retsyx/amity-esp32/amity-octopus-consortium/04-hardware-and-cec-runtime.md

# HDMI adapters and the local CEC runtime

This document owns hardware scope and the original local runtime with explicit user amendments. [Addressing](03-domain-model-and-addressing.md), [discovery](05-discovery-and-topology.md), [CEC behavior](06-cec-roles-and-message-policy.md) and [AGENTS.md](../AGENTS.md) define the operating model.

## Hardware scope

An Amity device supports the adapter capacity advertised by its compiled hardware profile. The existing board has one front/back adapter on GPIO1/GPIO2. The development XIAO ESP32-S3 profile supports up to four optional adapters, using overridable pairs 1/2, 5/6, 7/8 and 9/44. Each adapter has two independent CEC wires. Stable internal slots 0–3 are displayed as HDMI adapter 1–4; absent slots never compress numbering.

The shared limits in `components/amity_system/include/amity/hardware_limits.hpp`, Kconfig, release hardware identity and schemas must agree. Do not infer capacity from discoveries. Unsupported GPIO mappings or allocation errors cannot authorize driving an unintended wire. Keep the existing passive error/admin behavior of the selected profile.

The wires use external pull-ups with internal GPIO pulls disabled. Preserve the existing timer architecture and wire protocol/timing. A profile's GPIO mapping is part of firmware compatibility identity. Four-adapter simultaneous electrical/timing behavior requires its own physical qualification; a passing one-adapter capture is not that evidence.

## One original local runtime per adapter

Each configured adapter uses the same original front playback/back TV behavior and CEC algorithms. The owner task handles input, received frames, allocation/discovery, setup and completions while transmissions remain outstanding. Preserve original logical-address candidates, poll/announcement budgets, back-first scan, lowest usable back-device PA or saved fallback and the selected front PA, subject to the explicit live-default amendment below.

The **29 October 2026 scan/cache amendment** limits enumeration to boot, explicit UI scans and actual communication cache misses. Lookup cooldowns are 120 seconds independently per adapter side; boot/UI scans bypass eligibility and refresh their side timestamps. Logical-address claiming remains electrical maintenance and does not itself request a device scan. Activity edits preserve caches and active discovery progress without disconnecting an Amity; a side-only lookup scan retains the other side's records. [Discovery](05-discovery-and-topology.md) owns the full rule.

The distribution layer does not allocate identities from a persistent electrical-domain or proxy-resource graph. It selects an owner and adapter; the owner applies the original local algorithm there. Settings and actual hardware availability are separate from a stored approval to use an activity.

The shared `amity_hub` task has a 12 KiB internal-RAM stack. Coordinator activity
handling and owner-local execution can nest on that task even when equipment is
local. The `0.1.85` Xtensa Standby path retained at least 6,304 bytes before final
wire and runtime overhead, so the former 6 KiB allocation overflowed. This resource
allowance is shared across adapters and adds 6 KiB of internal RAM once. It
changes no CEC decisions, task priority, queue capacity or timing. Validate
boot/heap availability and actual Start/Standby wire effects when changing that
budget; [recorded evidence](15-validation-and-release-gates.md#functional-test-framework).

Synchronous ownership dispatch borrows one `OwnedIntent`: the dispatcher uses
a mutable reference to stamp sequence, setup and key-token fields, while the
facade and transport sender take const references. Queued commands and retained
key state own copies before the caller's request can expire. With the same
Xtensa optimization flags, the known nested Standby call-chain subtotal falls
from 6,112 to 3,968 bytes after this change, excluding final owner-send, CEC and
runtime overhead in both measurements. This is compiler stack-usage evidence,
not a runtime high-water measurement, and does not reduce the 12 KiB allocation
or change CEC behavior, IPC admission, deadlines or task ownership.

## Transmission and queue ownership

CEC mechanically transmits supplied frames and attempt budgets through one FIFO per wire, with eight queued-plus-active messages total. Releases share those eight slots. Full admission drops the submitted frame and logs it; every member of a rejected atomic batch is logged. No reserved release slot, executor outgoing backlog or later retry of a dropped release exists.

State and completion trackers belong to the original executor. Each held key continues after its own successful attempt; failed key TX ends it. New commands submit immediately without waiting for another key's ACK or queue capacity. Bounded task IPC remains appropriate where needed for causal request/state handoff.

The **29 October 2026 activity-sequencing amendment** requires a Start/Standby sequence to await each original lookup/command completion before its next step on the same Amity. Other owners and the owner loop may advance in parallel. During activity setting, ignore key presses before registering them; a release for an unregistered press is a no-op. Preserve the existing physical-input gate, with no ignored-press lifecycle or replay; normal independent keys resume after it clears. The continuation retains an original-function program counter in bounded semantic IPC, not CEC frames or a second transmit queue. [Activity execution](07-activity-planning-and-execution.md#2-reuse-the-original-decisions) owns this explicit sequencing rule.

## CEC connectivity and per-device settings

There are no separate adapter-presence inputs or attachment generations. A configured adapter exposes its actual CEC wires. A valid pulled-up bus permits normal CEC communication; device replies and command ACKs determine the result of each exchange. An absent adapter produces no CEC responses. Do not add a cache, sensor or bus-availability permission before ordinary owner-local lookup and transmission, or add detection pulses or pull-downs to a live CEC line.

Each adapter has its own saved default physical address. The owner uses it in the original startup algorithm; it is not a verified route or a stored PA-evidence grant. The final 2 November 2026 amendment permits explicit default edits to apply without reboot: after atomic save, select that adapter's stored latest scanned address when present, otherwise the new default. An applicable scan that finds no address clears the stored observation; normal scans keep the selected address stable until the next explicit default edit. No separate startup-source flag is retained. Apply through the owner task, reannounce an actually changed identity, preserve caches and authenticated connections, and do not enumerate. Configured-slot, fresh owner boot/settings-revision, idle/drain, authority and deadline checks remain. CEC silence does not prevent editing a configured slot. See [UI settings](20-user-interface.md#per-device-hdmi-adapter-settings-amendment--20-october-2026).

## Qualification

Host tests establish addressing, queue, state and transcript behavior. Physical checks must establish each GPIO/wire mapping, external electrical behavior, original CEC timing and ACK behavior, sparse/removable adapter safety, simultaneous adapter load and behavior under Wi-Fi/BLE/HTTPS load. Preserve the distinction between CEC ACK and actual AV picture/audio.
