retsyx/amity-esp32/tests/matter_pi_requirements.txt

# Isolated Raspberry Pi controller test tools; CPython 3.13 / Linux aarch64.
# Exact wheels used in the hardware tests. Firmware does not depend on these packages.
# wheel: aenum-3.1.17-py3-none-any.whl
aenum==3.1.17 --hash=sha256:8b883a37a04e74cc838ac442bdd28c266eae5bbf13e1342c7ef123ed25230139
# wheel: asttokens-3.0.2-py3-none-any.whl
asttokens==3.0.2 --hash=sha256:9da13157f5b28becde0bd374fc677dcd3c290614264eff096f167c469cd9f933
# wheel: cffi-2.1.1-cp313-cp313-manylinux2014_aarch64.manylinux_2_17_aarch64.whl
cffi==2.1.1 --hash=sha256:f16c709686a78c727bbbf059f92b0bf41c6fc60deec706d2dc19f529175a6125
# wheel: coloredlogs-15.0.1-py2.py3-none-any.whl
coloredlogs==15.0.1 --hash=sha256:612ee75c546f53e92e70049c9dbfcc18c935a2b9a53b66085ce9ef6a6e5c0934
# wheel: construct-2.10.70-py3-none-any.whl
construct==2.10.70 --hash=sha256:c80be81ef595a1a821ec69dc16099550ed22197615f4320b57cc9ce2a672cb30
# wheel: cryptography-50.0.1-cp311-abi3-manylinux_2_28_aarch64.whl
cryptography==50.0.1 --hash=sha256:e74591e283fe6eb956416c929eb58262a719fe0311fd9054c62c3350ed8760d8
# wheel: dacite-1.9.2-py3-none-any.whl
dacite==1.9.2 --hash=sha256:053f7c3f5128ca2e9aceb66892b1a3c8936d02c686e707bee96e19deef4bc4a0
# wheel: decorator-5.3.1-py3-none-any.whl
decorator==5.3.1 --hash=sha256:f47fe6fdbd2edd623ecfe36875d37aba411624e2670dd395dddae1358689bb3c
# wheel: deprecation-2.1.0-py2.py3-none-any.whl
deprecation==2.1.0 --hash=sha256:a10811591210e1fb0e768a8c25517cabeabcba6f0bf96564f8ff45189f90b14a
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
traitlets==5.16.1 --hash=sha256:f775618166caa0396c8e337099240f2bd3e5e917d203b2e6fbe21a58d3cb1f6b
# wheel: wcwidth-0.9.1-cp310-abi3-manylinux2014_aarch64.manylinux_2_17_aarch64.whl
wcwidth==0.9.1 --hash=sha256:b5da43d6967668982e44a52fb551967d293f86d26cd86036ac95bbdd34394ed9
