retsyx/amity-esp32/amity-octopus-consortium/11-configuration-storage.md

# Saved configuration and storage

The current configuration stores qualified equipment selections and original activity intent. [Addressing](03-domain-model-and-addressing.md), [execution](07-activity-planning-and-execution.md), [original-controller policy](21-original-controller-policy.md) and [AGENTS.md](../AGENTS.md) apply.

## Persistent configuration

Save stable component/activity IDs, labels, qualified OSD selectors, original display/source/audio/switch selections and input numbers, activity ordering and stable home-app slots/aliases. A selector is installation scope plus Amity device ID, HDMI adapter, front/back side and OSD name. Hostnames are presentation/network metadata.

Do not persist availability permissions, enabled flags, executable graphs, physical/logical runtime addresses, grants, held buttons or an activity-resume journal. Missing equipment remains selected and uses ordinary owner-local lookup. Preserve separate AVR/audio and explicit switch-input behavior.

## Current format and future changes

Only the current saved format is accepted. Its numeric `version` is checked against `current_configuration_version` (currently 3). Missing, malformed, older and future versions fail explicitly. No older decoder, conversion, compatibility alias, retained migration backup or migration-ID mapping is available. There is no promised compatibility with development snapshots before the first release.

Keep version validation, bounded parsing, explicit errors and the storage transaction boundary as the framework for a future deliberate format change. No automatic migration or format-change workflow runs today. Source types/functions and HTTP routes use versionless names; numeric format metadata remains validated.

Blank storage is initialized directly as an empty current-format configuration using the proven original controller and current hardware capacity. It does not read a name-only configuration or synthesize an old document. An unsupported or corrupt existing record fails closed; it must not be silently replaced by a blank configuration.

## Validation and persistence boundaries

Validate syntax, identities, selector scope, adapter bounds, references, field limits and ordering/slot invariants. Validation never requires equipment to answer or an approved physical path. Retain crash-consistent two-slot staging, readback/integrity validation, commit markers, expected revision checks and bounded storage admission. The current `AMITY3` record and storage-format-2 commit marker remain unchanged; no previous record format is decoded.

The controller saves valid intent independently of offline peers. Owner application reports both revisions through volatile status; enqueue success is not proof of application. Preserve unconditional configure-to-standby/generation behavior even for presentation edits. Presentation changes cannot rewrite OSD selectors or pairing ownership.

Activity edits preserve established authenticated connections and the HDMI
device observations at every owner. Publish a new transport revision after
the local Hub has applied the configuration and completed this Amity's original
old-recipe cleanup; local completion does not wait for a member acknowledgment.
Live members advance the exact revision over their existing TLS link using
the bounded configuration/owner-state snapshot exchange. This does not invoke
discovery or clear caches, change link/boot identity, or reset replay history.

The existing bounded network IPC retains immutable typed requests with their
original revision and deadline. Old-revision work is never relabeled; a new
revision uses fresh scope-bound grants after the in-place exchange. Expired,
wrong-scope and unauthorized work remains rejected. No encoded CEC backlog,
durable activity-resume journal or retry queue is added. An explicit destructive request made
while its reviewed link is still changing revision fails before roster/storage
mutation; a configuration save does not extend a reset or settings deadline.

Each owner completes its already-admitted old-recipe activity steps before
binding the replacement revision. The existing bounded typed IPC holds the
semantic continuation while CEC transmits; it does not hold encoded frames or
retry failed FIFO admission. The existing input release gate ignores new key
presses during selection/configuration setup; normal independent keys resume
after that gate clears. The original long-Power repair does not arm this gate.
The member's local bind
boundary does not delay the main's own configuration application or create a
cross-owner activity barrier.

A newly staged initial configuration or current hardware-capacity update may remain pending until protected local OTA boot health is confirmed. This is current-format transaction activation, not a format conversion. Keep its authority and flash-safety fences.

## Backup, restore and replacement

The ordinary Advanced workflow accepts only a current-format backup and preserves valid IDs, labels, selectors, role/switch fields, ordering and slots. Portable backups do not import Wi-Fi, private keys, operational trust, remote/home pairings or another controller's authority. Restore does not start an activity. Replacement owner mappings require explicit proven hardware choices; unresolved selections retain normal lookup behavior. See [recovery](13-faults-removal-and-recovery.md).

## Independent device state

Identity, membership trust, credentials, durable original-controller role, reset journals and hardware/adapter settings are separate records with their existing contracts. Preserve stable adapter slots, independently saved defaults and original back-first physical-address selection. An explicit default edit applies live after atomic persistence: select the stored latest scanned address when present, otherwise the new default. The optional scanned address is transient per adapter and is refreshed by applicable scans; no separate startup-source flag, saved topology or activity permission is retained. CEC silence is not detachment. Explicit member removal retains the durable reset journal and response-attempt boundary; authority loss alone does not reset a device.

## Evidence

Exercise current-format round trips, strict version/obsolete-field rejection, actual blank-storage startup, original authority, qualified selectors and storage cuts. Compare original local and remote AVR/audio, switch fallback, missing equipment/return and key behavior. Counts, labels and Ready alone do not establish behavioral parity.

The actual-runtime live-configuration test drives both sides of the existing
snapshot exchange over scripted authenticated TLS I/O, including old-scope
completion followed by new-scope owner state, unchanged connection/readiness
and observations, replay/obsolete-frame handling and fresh lease requirements.
The owner configuration-boundary test verifies old-recipe cleanup retains its
executing revision before the new context is stamped. Synchronization and
removal tests cover local application without member acknowledgments and
safe rejection of a destructive request crossing the revision boundary.
The actual-worker activity sequence regression also holds two old-recipient
Standby transmissions through completion before permitting a new owner bind,
then verifies that the old authorization is rejected.
