retsyx/amity-esp32/components/cec/README.md

> 20 October 2026 scope amendment: the original first-setup Amity alone owns the sole remote, UI/admin and home integrations. Added devices are UI-less actuators, with no member input gateway or coordinator promotion/handover. Preserve the original activity UI with only canonical Amity-hostname context and one Amity management tab. [Normative contract](../../amity-octopus-consortium/21-original-controller-policy.md).

`cec::Engine` is a standalone, allocation-free CEC wire state machine. It has
no knowledge of Amity, device types, opcodes, or GPIO numbers. `cec::Bus` adds
the ESP-IDF GPIO/GPTimer and FreeRTOS queue bindings. Its GPIO is always open
drain; the board supplies the CEC pull-up. All active buses share one GPTimer
while retaining independent wire engines.

The timer samples every 50 microseconds. Start bits are 3.7 ms low / 4.5 ms
total. Data bits are 0.6 ms or 1.5 ms low / 2.4 ms total. The engine samples at
1.05 ms, acknowledges its allocated address, leaves broadcast ACK high,
detects arbitration loss, validates receive pulse widths, and abandons a
transmission when an ISR delay exceeds 200 microseconds. Direct and broadcast
acknowledgements have opposite polarity. Frames are bounded to 16 bytes.
These protocol timing values can also be checked against the
[Linux CEC pin driver's timing definitions](https://github.com/torvalds/linux/blob/master/drivers/media/cec/core/cec-pin.c).
This component is an original implementation, not a copy of that driver.

Local and distributed execution use the same `main` behavior. Distribution
only delivers messages to the owning wire; it must not change frames, order,
attempt budgets, admission or completion semantics. The APIs below provide
transport plumbing rather than alternate native/compatibility CEC policies.

Physical transmission is serialized within each wire's sole FIFO. All buses
use one bounded nonblocking dispatcher with independent queues and in-flight
state. `QueueProfile::Legacy` and `QueueProfile::Native` are compatibility
aliases and select identical CEC execution, capacity and receive behavior. `submit_guarded()` and `submit_guarded_batch()` admit work
immediately; `take_completion()` reports each operation token's terminal result
and whether a frame started. An explicitly submitted batch is admitted entirely
or returns busy without enqueuing a prefix. This generic batch facility does not
change the executor's sequential finite-key press/release admission. All receive queues have 32 entries.

`send_async_guarded()` supplies the same submission/completion split with
caller-owned result storage. It attempts admission immediately and returns without
waiting for transmission or an ACK. Its caller-owned `TxCompletion` becomes
Pending on admission; the worker publishes a terminal result after releasing
FIFO capacity. Read the result with acquire ordering before reusing the
tracker, and keep both tracker and bus alive until completion. Rejection leaves
the tracker unchanged. Separate operations have separate completion trackers:
one pending ACK cannot block admission on its wire or progress on another wire.
This matches [Python Amity's CEC transmitter](https://github.com/retsyx/amity/blob/main/cec.py#L669-L683).

Runtime commands, held keys, activity setup, discovery and address allocation
submit without blocking the owner on CEC capacity or ACKs. Frames that do not
need completion tracking also use immediate admission. A one-byte poll can use
one attempt for logical-address allocation/discovery. Every profile has one TX
FIFO per wire, with eight slots counting queued and active messages together.
This is the only outgoing-frame buffer; the executor submits directly without
another frame queue.

All submissions reject at eight queued-plus-active messages, including releases.
There is no release reserve or overflow permission. A rejected release is dropped
without an executor admission retry. Every TX dropped because the FIFO is full is
logged, including each frame of a rejected atomic batch. CEC applies admission
mechanically without inspecting opcodes.

CEC has no button state, key retry policy, repeat loop or release authority.
It sends the exact supplied frames with supplied attempt budgets and generic
deadline/generation guards, then reports outcomes. It must not inspect an opcode
to select a retry budget or create a semantic message. The executor supplies
one attempt for every key-press frame and up to three for final release and
ordinary commands. Each held key has at most one outstanding attempt; its
completion controls only that key's continuation. No hub task waits for an ACK,
and there is no repeat timer or backlog of repeat frames. Failed key TX ends
only that key's pressed state. The executor supplies one final release when all
keys at that `(physical wire, initiator, destination)` have ended, including
last-key failure. CEC's `USER_CONTROL_RELEASED` has no key operand. Key-up does not cancel already
admitted frames or another key's completion. CEC only buffers and transmits the
supplied release; it never derives that decision from an opcode or completion.
Bounded completion and guard metadata is retained through terminal completion,
including after cancellation. Generic guards support exceptional invalidation;
a normal button-up does not advance a global generation guard.

An absent device's polling NACK does not increment the error counter.
The receiver remains running during transmission and follows the winning
initiator after arbitration loss. Ordinary messages use a conservative seven
bit-period idle interval; retries use three.

Terminal transmission failures are logged by the existing worker with the
exact frame, actual attempt count and whether transmission started.
`LineError` additionally identifies a `TickGap` (more than 200 microseconds
between callbacks), `LowLine` (the sampled line remains low at least 1.8 ms into
a data/ACK bit), or task-side `BeginRejected`. The log records monotonic
`at_us`, actual `gap_us`, bounded `elapsed_us`, slot/byte/bit, `within_us` and
sampled line level. Slot -1 denotes the start bit; -2 denotes a timing gap
beyond the frame's data slots. A LineError alone does not establish an external
electrical fault.

The ISR captures only fixed-size numeric evidence. Its existing one-result
queue transports the complete attempt result, diagnostic and started flag
together, so later ticks or a new attempt cannot replace the worker's evidence.
Logging and formatting remain outside the ISR and wire lock. These diagnostics
do not alter any timing threshold, attempt budget, FIFO slot, guard or frame.

Enable `CONFIG_GPTIMER_ISR_CACHE_SAFE` and
`CONFIG_GPTIMER_CTRL_FUNC_IN_IRAM`. All wire paths and their literal pools
reside in IRAM, and ISR state and queues are allocated in internal RAM. GPIO
access uses ESP-IDF's GPIO LL functions so cache-disabled flash/OTA operations
do not send the ISR through flash-resident functions.

Keep `CONFIG_ESP_MM_CACHE_MSYNC_C2M_CHUNKED_OPS=y` with
`CONFIG_ESP_MM_CACHE_MSYNC_C2M_CHUNKED_OPS_MAX_LEN=0x100`. The pinned SDK masks
interrupts during PSRAM cache writeback. On 2 November 2026, a same-boot capture
correlated a 206-microsecond CEC gap with `system_sync` returning from a critical
section inside SHA's 2,496-byte cache writeback (217 microseconds including the
interrupt). The SDK's 256-byte chunks restore interrupts between chunks while
preserving its cache-coherence handling. Its default 32 KiB chunk would not
split this request. This changes neither CEC timing nor attempts, task affinity,
configuration hashing or application synchronization. Temporary task/register
and cache-call probes were removed after attribution. Diagnostic evidence is
under `test-results/cec-line-errors-2026-11-01/`, including `cause-128.json`.

Run `sh tests/cec_hub_test.sh` from the repository root for host simulation
under ASan/UBSan. Also run
`sh tests/cec_runtime_test.sh` for the shared native runtime and completion-token
API, and `sh tests/system_hold_test.sh` for the executor policy.
`tests/cec_runtime_driver_test.cpp` exercises
immediate admission during an outstanding ACK, individual completion results,
FIFO capacity/reuse and independent buses. The hub tests cover independent
held keys, recipient release, failure cleanup and activity settling without
blocking command admission. After flashing the complete firmware, the
[Python functional harness](../../cec-harness/README.md) runs one HDMI scan
against `amity-dut` with a dynamically created TV, AVR and playback device.
It uses the existing authenticated UI controls, verifies fresh CEC discovery
traffic and the resulting equipment identities, and clears the virtual device
addresses on exit. Physical wiring is maintained in
[`cec-harness/TEST-HARNESS.md`](../../cec-harness/TEST-HARNESS.md).
This scan qualifies discovery and fixture cleanup; complete CEC transmission,
activity and remote-input parity require their own physical evidence.
