retsyx/amity-esp32/components/amity_hub/CONTROL_SURFACE_EVIDENCE.md

# Control-surface and behavior evidence

The current contract is original local Amity plus qualified owner delivery, as recorded in [AGENTS.md](../../AGENTS.md), [addressing](../../amity-octopus-consortium/03-domain-model-and-addressing.md), [execution](../../amity-octopus-consortium/07-activity-planning-and-execution.md), [UI](../../amity-octopus-consortium/20-user-interface.md) and [role policy](../../amity-octopus-consortium/21-original-controller-policy.md).

Canonical schema 3 retains original activity fields, qualified owner/adapter/side/OSD selections, IDs, labels/order/slots. No persistent enabled/route/binding/resource/domain/capability/PA approvals remain part of the execution model. Missing equipment stays configured. Controller decisions and owner-local CEC handling use the original algorithms, including separate AVR audio and switch-input fallback.

## Required software evidence

Compare baseline `98e64a6`, qualified all-local handling and authenticated remote-owner delivery for the same activity, observations and input. Assert frames/wires/order/attempts/admission/key lifecycle. Include absent names and return without configuration mutation, scoped duplicates and LA changes during holds, original per-adapter discovery/PA, AVR/switch, same-target repair, input gate/macros/swipes and FIFO8 failure/release behavior.

Verify original form fields/order and scoped device choices, stable external identities, missing-choice retention and real backend dispatch. Verify sole original role/UI/remote/integrations, headless member boot and stale/auth rejection. A rendered form, retained metadata, successful build or Ready endpoint alone cannot prove these behaviors.

## Current task evidence

Current selector-model checks and native-build outcomes are recorded in [design validation](../../amity-octopus-consortium/VALIDATION.md) and [implementation status](../../IMPLEMENTATION_STATUS.json) after execution. Do not infer completion from this requirements document. Historical schema-2 planner/profile/graph test results remain historical and are not proof of the new execution path.

The prior 0.1.80 device upgrade verified image/startup and retained credentials/configuration fields. Its six-activity migration left four AVR/switch activities disabled; that was a behavioral regression, not activity parity. The current regression coverage must demonstrate those activities invoke original local/remote handling without a repair/enable workflow.

Physical ESP32-to-ESP32 radio/CEC, actual remote gestures, AV picture/audio, full FIFO/loss under combined load, four-adapter electrical timing, detachable hardware, ecosystem retention/manual recovery and production security remain separately qualified. No new physical device result is implied by host tests or documentation.
