retsyx/amity-esp32/hw/octopus/mfr/hdmi-bom.csv

Reference | Quantity | Value | Manufacturer | MPN | Footprint | Description | Tolerance | Voltage Rating | Power Rating | Dielectric | Datasheet | Assembly Notes
C1 | 1 | 1uF | TDK | C1608X7R1C105K080AC | Capacitor_SMD:C_0603_1608Metric | 1 uF ceramic capacitor, 10%, 16 V, X7R, 0603, 0.8 mm height | 10% | 16 V |  | X7R | https://product.tdk.com/system/files/dam/doc/product/capacitor/ceramic/mlcc/catalog/mlcc_commercial_general_en.pdf
D1,D2,D4,D5,D6,D7,D8,D9 | 8 | 4148 | Taiwan Semiconductor | TS4148 RCG | Diode_SMD:D_0603_1608Metric | Fast switching diode, 75 V, 100 mA, 4 ns, ceramic 0603 |  |  |  |  | https://services.taiwansemi.com/storage/resources/datasheet/TS4148%20SERIES_A2301.pdf
D3 | 1 | ESD3.3 | onsemi | ESD9B3.3ST5G | Diode_SMD:D_SOD-923 | Bidirectional ESD protection diode, 3.3 V standoff, SOD-923 |  |  |  |  | https://www.onsemi.com/download/data-sheet/pdf/esd9b-d.pdf
J1,J3 | 2 | E5J88-00AJG2-L |  |  | Pulse_Electronics:RJ45_Pulse_E5J88-00AJG2-L_Horizontal_EdgeMount | Dual unshielded RJ45 jack, 2 ports of 8 contacts, horizontal through-hole |  |  |  |  | https://www.mouser.com/datasheet/2/447/E5J88_00AJG2_L-2902971.pdf
R1,R2,R4,R5,R6,R7,R8,R9 | 8 | 27K | Bourns | CR0603-JW-273ELF | Resistor_SMD:R_0603_1608Metric | 27 kohm thick-film resistor, 5%, 0.1 W, 0603 | 5% |  | 0.1 W |  | https://www.bourns.com/docs/Product-Datasheets/chpreztr.pdf
R3 | 1 | 10K | Bourns | CR0603-FX-1002ELF | Resistor_SMD:R_0603_1608Metric | 10 kohm thick-film resistor, 1%, 0.1 W, 0603 | 1% |  | 0.1 W |  | https://www.bourns.com/docs/Product-Datasheets/chpreztr.pdf
SW1 | 1 | FW RESET | Omron Electronic Components | B3U-1000P | Button_Switch_SMD:SW_SPST_B3U-1000P | SPST-NO momentary tactile switch, top actuation, 1.5 N, SMT, without locating boss |  |  |  |  | https://omronfs.omron.com/en_US/ecb/products/pdf/en-b3u.pdf
U1 | 1 | XIAO-ESP32-S3-SMD | Seeed Studio | 113991114 | Seeed_Studio_XIAO_Series:XIAO-ESP32-S3-SMD | XIAO ESP32-S3 module, 8 MB flash, 8 MB PSRAM, USB-C, 21 x 17.8 mm |  |  |  |  | https://files.seeedstudio.com/Bazaar/product_pdf/113991114.pdf
