retsyx/amity-esp32/hw/tentacle/mfr/hdmi-bom.csv

Reference | Value | Datasheet | Footprint | Qty | DNP
J1,J2 | HDMI_A | https://www.digikey.com/en/products/detail/amphenol-cs-fci/10029449-001RLF/1001325 | Connector_Video:HDMI_A_Amphenol_10029449-x01xLF_Horizontal | 2
J3 | RJ45 |  | Pulse_Electronics:RJ45_Pulse_E5J88-00LJG2-L_Horizontal_EdgeMount | 1
