retsyx/amity-esp32/hw/octopus/models/RJ45_Pulse_E5J88-00AJG2-L_Horizontal.step

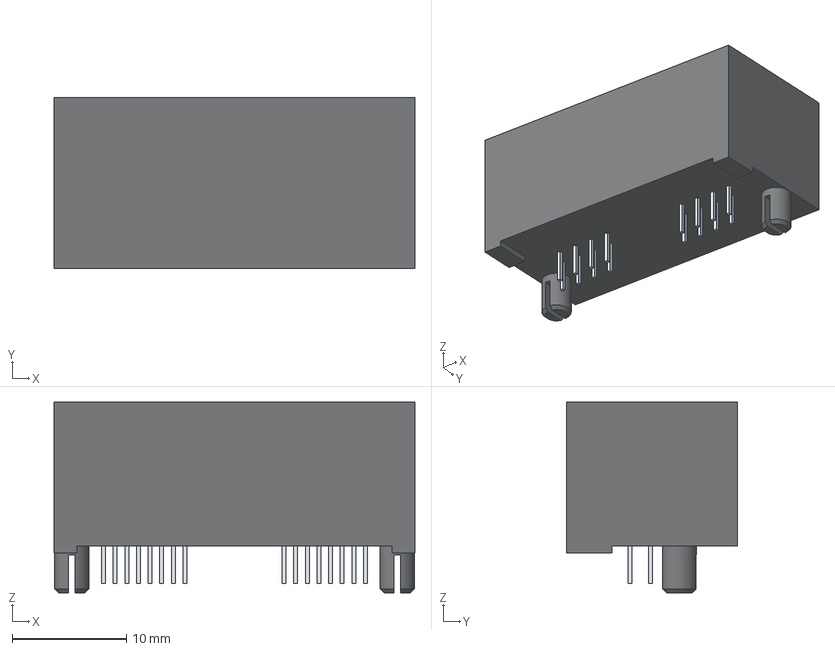
[picture p1: CAD file, 2026-11-07]
hw/octopus/models/RJ45_Pulse_E5J88-00AJG2-L_Horizontal.step
31.6 x 15.0 x 16.7 mm
shared_black_nylon_housing
pin_1_tin_tail
pin_1_gold_contact
pin_2_tin_tail
pin_2_gold_contact
pin_3_tin_tail
pin_3_gold_contact
pin_4_tin_tail
pin_4_gold_contact
pin_5_tin_tail
pin_5_gold_contact
pin_6_tin_tail
pin_6_gold_contact
pin_7_tin_tail
pin_7_gold_contact
pin_8_tin_tail
pin_8_gold_contact
pin_9_tin_tail
pin_9_gold_contact
pin_10_tin_tail
pin_10_gold_contact
pin_11_tin_tail
pin_11_gold_contact
pin_12_tin_tail
pin_12_gold_contact
pin_13_tin_tail
pin_13_gold_contact
pin_14_tin_tail
pin_14_gold_contact
pin_15_tin_tail
pin_15_gold_contact
pin_16_tin_tail
pin_16_gold_contact
