retsyx/amity-esp32/hw/octopus/models/RJ45_Pulse_E5J88-00LJG2-L_Horizontal.step

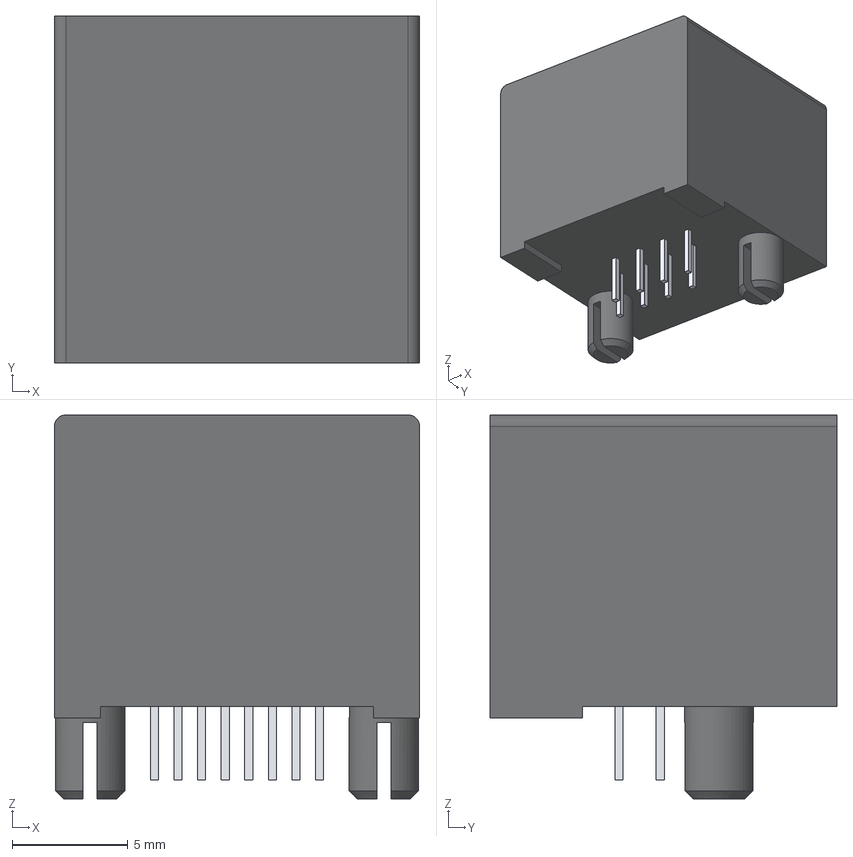
[picture p2: CAD file, 2026-11-07]
hw/octopus/models/RJ45_Pulse_E5J88-00LJG2-L_Horizontal.step
15.8 x 15.0 x 16.6 mm
black_nylon_housing
pin_1_tin_tail
pin_1_gold_contact
pin_2_tin_tail
pin_2_gold_contact
pin_3_tin_tail
pin_3_gold_contact
pin_4_tin_tail
pin_4_gold_contact
pin_5_tin_tail
pin_5_gold_contact
pin_6_tin_tail
pin_6_gold_contact
pin_7_tin_tail
pin_7_gold_contact
pin_8_tin_tail
pin_8_gold_contact
