retsyx/amity-esp32/test-results/README.md

# Local test output

Generated test evidence, serial/controller logs, credentials, browser images,
and fixture backups belong here and are ignored by Git. Some contain Wi-Fi,
Matter, or administration secrets. Keep credential files mode 0600 and do not
publish this directory. The public summary is the
[implementation and validation status](../IMPLEMENTATION_STATUS.json).
