retsyx/amity-esp32/amity-octopus-consortium/TODO.md

# Remaining implementation work

Recorded 20 October 2026 after a read-only audit of firmware 0.1.60, then updated for the original-controller requirements and 0.1.62 source cleanup. Open checkboxes below require evidence. Obsolete member-input, controller-transfer and replacement-wizard requirements are removed from the current contracts. Passing the existing tests does not close these gaps; record the implementation and relevant validation evidence before checking an item off.

This is the software and release-process backlog. Physical qualification remains tracked in [validation and release gates](15-validation-and-release-gates.md), [engineering gates](17-decisions-and-open-questions.md), and the [implementation status](../IMPLEMENTATION_STATUS.json).

The current CEC admission amendment is eight total messages per wire, including active work and releases. There is no extra release slot. Full-FIFO releases are dropped permanently without executor admission retry, and every TX dropped because the FIFO is full is logged, including every frame of a rejected atomic batch. Necessary bounded task-to-task communication queues remain permitted; they must not become outgoing-message or retry backlogs.

**21 October 2026 preservation rule:** original Amity algorithms and functionality at `d50af8026938797fc0820d0107f4c4e064c2d2bc` remain authoritative unless the user explicitly asks for a change. The consortium adds ownership and transport around those algorithms. Every item below must preserve existing behavior and approved user amendments; a backlog proposal is not authorization to redesign the original algorithms. See [AGENTS.md](../AGENTS.md) and the [normative amendment](21-original-controller-policy.md#original-algorithms-and-functionality-amendment--21-october-2026).

## Original algorithm preservation

- [ ] **PARITY-01 — Complete original-algorithm parity evidence.** Compare each affected local and distributed execution path with the baseline source/tests, including activity/AVR/audio/switch behavior, discovery, physical-address selection, remote input, CEC transmission/retries and approved UI workflows. Explicitly include Siri remote swipes: recognition/thresholds/direction/acceleration, timing, generated press/release sequences, interruption and activity-generation handling must match the original for local and remote targets. Restore unrequested differences rather than treating newer code/specs as authoritative. Record necessary ownership/transport/fencing adaptations and explicit user-requested exceptions. Known typed-runtime gaps include baseline play/pause emulation (raw `0x61` maps to remembered play/pause and stays mapped throughout a hold) and scoped audio/mute feedback from `0x7a` reports; query emission alone does not establish audio-status projection parity. ACT-01/02 and physical parity evidence remain open independently.
- [x] **INPUT-01 — Owner-local held-button execution (software implementation).** Firmware 0.1.73 transports initial down and exact-token up only, without per-button renewal/lease expiry. This historical firmware used commands-first pacing, superseded by current `main`: keys complete independently and new commands submit immediately while ACKs remain pending, with one wire attempt per key press. Failed TX ends that key; later up is a no-op. Release is implicit at recipient stream end only when all keys there cease being pressed, including last-key failure. Joined finite taps cannot release another held key. The executor submits directly without an outgoing-frame queue; CEC mechanically applies supplied frames, attempts and fences. The historical extra release slot is superseded by the current eight-total-message limit; full-FIFO releases drop without later admission retry and all full-FIFO TX drops must be logged. The linked historical 0.1.73 evidence predates this capacity amendment. Necessary bounded IPC remains handoff only. Exact current-state classification makes failed-key up harmless under IPC pressure without new queues or expiring outcome/history guesses. Initial freshness, current authority, safe binding fences and original audio-query timing remain distinct. Focused [core/aggregate holds](../test-results/aggregate-core-holds-0.1.73.log), [actual runtime](../test-results/aggregate-system-remote-control.log), [driver](../test-results/direct-submit-cec-final.log), [synchronization](../test-results/state-change-sync-final.log) and [exact native artifact](../test-results/owner-repeat-artifact-0.1.73.json) checks pass. Physical qualification remains **INPUT-03**, and broader baseline parity remains **PARITY-01**.

- [ ] **INPUT-03 — Qualify physical remote/CEC behavior on real owners.** Capture actual Siri gestures, finite taps and several-second held volume with both local and another Amity's audio component. Verify one inter-device down/up, successful completion pacing, one wire attempt per key press, failed key TX ending that key, final release only when all recipient keys end, later up doing nothing, overlapping keys/taps and independent recipients, eight-total-message CEC-only buffering, permanently dropped full-FIFO releases and logging of every full-FIFO TX drop, full-FIFO up handling, lost links and stale tokens. Include radio/HTTPS/scan load and sparse removable adapters. Host traces, exact source parity and an idle Ready-after-OTA check do not close this gate.

## Original-controller and baseline-UI amendment implementation

- [x] **CTRL-01 — Enforce immutable original-controller identity (software implementation).** Migrate proven originals once, reject changed live controller IDs, extra/member-owned remotes, input delegation and promotion/handover. Preserve unrelated bonds/IDs while disabling member control. One firmware starts fresh without Wi-Fi/UI; checked Matter BLE completion or authenticated member BLE preparation chooses a durable role, independent of later Matter fabric removal. The current frozen 0.1.62 host suite passed (`test-results/cleanup-host-0.1.62.log`), including actual startup/service bodies and negative-admission tests. Exact native image/service audit passed in [implementation status](../IMPLEMENTATION_STATUS.json). Physical SC-01/02/04/06/07 evidence remains a separate gate; explicit fresh-main recovery is REC-01.
- [x] **CTRL-02 — Make added devices UI-less actuators (software implementation).** Original only: web/setup/admin/recovery pages, Matter/HomeKit and remote. Keep shared network/NimBLE and authenticated peer OTA/config/status; cancel prior services/work on adoption without deleting pairings. The current 0.1.62 actual service/startup bodies and BLE worker tests cover prestart/live revocation, checked role enrollment, disabled members and delayed-work races. Evidence: `test-results/cleanup-host-0.1.62.log` and the full-runner actual service/startup/BLE tests. Exact native image and linked service audit passed in `test-results/cleanup-services-elf-audit-0.1.62.json`; physical SC-03/04 confirmation remains a separate open gate. Historical 0.1.60 HIL does not prove this amendment.
- [ ] **CTRL-03 — Restore baseline UI behavior with the approved amendments.** Match commit d50af8026938797fc0820d0107f4c4e064c2d2bc Activities/Remote/Matter/HomeKit/Advanced, original activity fields/controls and AVR/audio/switch behavior. Retain the approved navigation order Activities, Remote, Matter, HomeKit, Amity devices, Advanced (Advanced last), plus canonical Amity-hostname context and the per-device settings exception. No guided wizard, Equipment/Settings, new remote mapping or primary-zone choices. Validate amended UX-01–UX-16 and one remote selecting multiple screens.

Current 0.1.62 software checks and Ready-after-OTA evidence are separate from historical 0.1.60 full bench tests. CTRL-03 remains open even after baseline form/browser restoration: runtime gaps below still prevent full AVR/audio/switch behavior parity. [Normative amendment](21-original-controller-policy.md).

- [x] **CLEAN-01 — Validate the reduced current authority surface (software implementation).** Obsolete delegated-input, multi-remote, controller-transfer and guided-interface APIs, files and positive fixtures are removed; scoped multi-CEC actuator execution remains. The frozen 0.1.62 complete host suite, fresh isolated native build, checks for 41 consistent layouts, artifacts and linked services, baseline browser fixtures,13 Amity checks and14 member-update checks passed. Evidence: `test-results/cleanup-host-0.1.62.log`, `test-results/cleanup-build-0.1.62.log`, `test-results/cleanup-artifact-0.1.62.json`, `test-results/cleanup-services-elf-audit-0.1.62.json`, the [final validation index](../test-results/cleanup-validation-index-0.1.62.json), and [implementation status](../IMPLEMENTATION_STATUS.json). Exact development image is Ready after OTA; live original UI, configuration retention and removed-route rejection passed. The DUT was unbonded, so no paired-remote identity is established. Physical multi-device/electrical/AV/pairing qualification is not closed. Prior 0.1.61 logs remain historical. Only presence-based passive rejection of old transfer journals and private read-only migration of legacy configuration fields remain permitted.

- [x] **UI-01 — Verify the main in the Amity devices list.** Main is always first with its actual hostname and inline **(this device)** in the title, including a system with no added devices. Settings is right-aligned in the title row; added-device Settings and Remove share that row. It has no member Remove/Replace/Update firmware actions; its Advanced update workflow remains. The historical 0.1.63 Location alias is superseded by NAME-01 below. The unnecessary management paragraph is removed. Focused 0.1.63 fixtures passed: 14 interface checks and 14 member-update checks. Fresh isolated native/artifact checks, exact authorized OTA Ready, all nine original configuration retention checks and actual read-only live UI verification passed; all six activities retained without replay. See the [0.1.63 validation index](../test-results/device-list-validation-index-0.1.63.json) and [implementation status](../IMPLEMENTATION_STATUS.json). No new complete host run is claimed; the full 0.1.62 record remains historical. ACT-01/02 and physical qualification remain open.

- [x] **UI-02 — Put Advanced last.** Navigation is Activities, Remote, Matter, HomeKit, Amity devices, Advanced. The 0.1.67 [23 browser checks](../test-results/controller-system-ui-0.1.67.json), exact native/artifact checks, authorized DUT update and [live tab-order verification](../test-results/tab-order-dut-ui-0.1.67.json) passed; the saved configuration and all six activities were retained. Only HTML order and version metadata changed in firmware; the complete 0.1.66 host result remains historical. See the [validation index](../test-results/tab-order-validation-index-0.1.67.json).

- [x] **UI-03 — Align device names and controls.** The main heading reads `<hostname> (this device)`. Settings and any Remove/Replace button share the title row, aligned right. The 0.1.69 [24 system browser checks](../test-results/controller-system-ui-0.1.69.json) include row geometry at 320, 430 and 1280 pixels; 14 member-update checks passed. Exact native/artifact checks, authorized DUT update and [live responsive main-row/settings verification](../test-results/device-row-dut-ui-0.1.69.json) passed, preserving configuration and all six activities. Added-device row geometry uses shipped-script fixtures; no physical member was present. See the [validation index](../test-results/device-row-validation-index-0.1.69.json). No new complete host run is claimed for this JS/CSS layout and version-only change; full 0.1.66 host evidence remains historical.

- [x] **NAME-01 — Make Amity names actual hostnames (software implementation).** Device rows and equipment choices use canonical actual hostnames, including authenticated durable names for offline devices; unknown legacy names show **Name unavailable**, never an old cosmetic label. Add requires a 1–32-character DNS-label Name, normalized to lowercase without slugifying invalid text; missing/invalid/duplicate names reject before radio. Bootstrap profile 2 authenticates the requested hostname and applies it before Wi-Fi staging. Independent Location aliases/actions are removed; main hostname changes stay in Advanced and no member-rename flow is added. The complete frozen 0.1.64 host suite, 14 interface/14 member-update browser checks, fresh native/artifact checks, exact authorized OTA Ready, ten live configuration retention checks, six inert invalid-admission checks and actual read-only UI passed. Existing hostname, all six activities, IDs and authority stayed unchanged; no live candidate was enrolled. See the [0.1.64 validation index](../test-results/hostname-validation-index-0.1.64.json) and [implementation status](../IMPLEMENTATION_STATUS.json). Physical profile-2 named induction/reboot/network verification remains open, along with ACT-01/02 and other qualification gates.

## Per-device HDMI-adapter preferences

- [x] **PA-01 — Replace the singleton Advanced front-address fallback with per-device Settings (software implementation).** Four stable connector-indexed defaults preserve slot-0-only legacy migration; the UI shows only the profile's supported capacity, retaining all holes on four-adapter profiles. Detected/selected diagnostics never promote fallback into topology authority. Only configured positively present adapters are editable. Exact boot/settings/presence generations, owner idleness/quiescence and original deadlines fence the write; a bounded started write returns its actual result. Durable success restarts only the selected device after response transmission attempt, including a failed attempt; reads do not scan or wake and uncertain client outcomes never auto-replay. The complete frozen [0.1.65 host suite](../test-results/adapter-settings-host-0.1.65.log), actual-owner [native](../test-results/adapter-native-owner-0.1.65.log)/[typed runtime](../test-results/adapter-live-owner-0.1.65.log) ASan/UBSan tests, [21 browser settings checks](../test-results/adapter-settings-ui-0.1.65.json), strict [360-vector peer schema/codec comparison](../test-results/adapter-settings-schema-vectors.json), native build/artifact checks and exact authorized [DUT installation](../test-results/adapter-settings-dut-installed-0.1.65.json) passed. [Live settings evidence](../test-results/adapter-settings-dut-settings-0.1.65.json) covers seven inert invalid/stale rejections plus a same-value durable save, one revision increment and selected-target restart; [post-restart evidence](../test-results/adapter-settings-dut-after-0.1.65.json) preserves the fallback, hostname, controller, configuration and all six activities without resume. Physical removable-adapter detection/electrical, real multi-adapter behavior, authenticated remote-owner save/restart and lost-response recovery remain open qualification gates; this fixed legacy-DUT test does not close them. ACT-01/02 remain open. Contract: [settings UI matrix](20-user-interface.md#per-device-hdmi-adapter-settings-amendment--20-october-2026).

## Added-device removal

- [x] **REMOVE-01 — Apply factory-reset semantics to added-device removal (software implementation).** Responding committed devices drain and durably schedule their existing factory reset, acknowledge only `reset_scheduled`, then restart the selected target after the reply attempt, including a lost reply. Offline devices are dropped locally with physical-button instructions and no queued reset on reconnect. Reviewed membership revision/target Boot, exact authenticated scope, immutable main authority and negotiated capability fence the operation; generic retirement/enrollment abort cannot erase a device. The [complete frozen 0.1.66 host suite](../test-results/removal-host-0.1.66.log), service/reset-journal ASan/UBSan tests with 46 erase cuts plus three marker cuts, [23 removal/interface browser checks](../test-results/controller-system-ui-0.1.66.json), [105 codec/schema vectors](../test-results/removal-reset-schema-vectors.json), 27 independent synthetic-peer tests and exact native/artifact checks passed. [DUT evidence](../test-results/removal-dut-admission-0.1.66.json) confirms exact 0.1.66 Ready, seven inert invalid/self/stale rejections, retained configuration/hostname/defaults and six activities without resume. [Served UI evidence](../test-results/removal-dut-ui-0.1.66.json) includes a display-only confirmation preview with removal POST blocked. No real added device was reset; physical qualification remains REMOVE-02. Contract: [intentional removal](13-faults-removal-and-recovery.md#intentional-removal).

- [ ] **REMOVE-02 — Qualify removal/reset with real added Amity hardware.** Exercise responding and offline devices, management-only compatibility, active sessions/held cleanup, response loss before/after the durable marker and interrupted restart. Verify only the selected device clears mutable Wi-Fi/settings/pairings/group state, preserves factory/Add authorization and firmware, and starts without a UI or Wi-Fi until fresh BLE setup. Verify offline removal never causes a delayed reset on reconnect, the old credential stays rejected, and the physical at-least-ten-second button reset permits fresh enrollment. Synthetic tests and main-only inert DUT checks do not close this gate.

## Baseline activity behavior parity

- [ ] **INPUT-02 — Complete broader remote/control-adapter parity.** Restore the baseline play/pause emulation and scoped audio/mute status projection listed in PARITY-01. Verify that a new explicit key command from another original-controller adapter supersedes an existing held key as the original `stop_hold` path did; current typed same-binding admission can report a hold conflict instead. Preserve exact cleanup and reject stale input without inventing a new gesture or repeat algorithm. Siri source parity and finite-swipe/held-volume software regressions are evidence for their covered paths, not closure of these broader gaps. Physical Siri/remote/CEC parity remains a separate gate.

- [ ] **ACT-01 — Execute supported new AVR/audio/switch configurations.** The baseline fields are restored and existing proven routes retain their records, IDs, slots and aliases. Newly selected receiver/audio/switch paths without an executable supported model are saved disabled with a reason. Implement and validate their scoped bindings, power/routing/resource dependencies and guarded execution; preserving a form or saving a disabled activity does not satisfy legacy behavior parity. Do not infer an unknown receiver output or hardware path.
- [ ] **ACT-02 — Execute scoped vendor power quirks in the typed runtime.** Schema2 retains component/vendor-qualified power-on/off payloads, but only the legacy Hub currently consumes them. Compile qualified per-endpoint templates into the exact owner policy, validate current vendor/binding evidence, preserve original deadlines and first-edge fences, and generate matching key release when needed. Cover local and remote owners, reconfiguration and stale evidence before claiming parity; never expose unguarded arbitrary CEC forwarding.

## Manual recovery after main failure

- [x] **REC-01 — Restore a backup onto a freshly enrolled replacement main (software implementation).** Existing Advanced upload/restore requires fresh claimed/empty main, exact configuration/presentation/Boot, `confirm:true` and `previous_controller_isolated:true`. Preserve logical activity/device IDs, names/order, sparse slots/tombstones and nonsecret choices. Drop old executable routes/bindings/resources/PA evidence, remote assignment and member domains; restored activities stay disabled until fresh Scan and original Edit/Save repair a supported path (ACT-01 remains open). Normal live controller edits/promotion remain rejected. `tests/activity_editor_test.sh`, strict codec/60 storage cuts, existing-browser restore checks and the complete current 0.1.62 host suite passed; see `test-results/cleanup-host-0.1.62.log` and `test-results/cleanup-system-ui-0.1.62.log`. Physical SC-08 remains open: re-pair the remote/home integrations, factory-reset old headless members with the existing ≥10-second hold, retain origin/Add authorization, then re-add through the 3-to-below-10-second window using fresh operational keys/trust. No old roster/key/lease import, automatic failover or new wizard.

## Release pipeline and artifact integrity

- [x] **REL-01 — Publish complete OTA downloads.** Build output, CI packaging/checksums and release arguments include `amity-update.bin`, its exact `amity.release.json`, and the optional publisher `.sig`. The original browser file picker consumes the bounded one-file container; the target verifies its metadata before erasing and streams only the unchanged native image. Local validation executes the actual packaging script and publication shell with a nonnetworked `gh` stub, plus the actual target header/parser/upload paths and tool checks: [bundle tests](../tests/update_bundle_test.py). These tests do not claim a GitHub publication or physical OTA of the new format. [Build packaging](../.github/workflows/build-firmware.yml), [release publication](../.github/workflows/release-firmware.yml), [contract](14-ota-and-compatibility.md).

- [ ] **REL-02 — Bind the security profile to the image.** Embed and verify the candidate image's compiled security profile; reject a release manifest that labels a development image as production. Preserve the requirement for physically authorized profile changes. The current [manifest generator](../tools/release_manifest.py) accepts the profile as caller input. This is a release/operator mistake prevention gap; a mislabeled production update would still require authorized publisher and native signing.
- [ ] **REL-03 — Preserve the original build provenance.** Generate source-tree, commit, dependency and security-profile identities during the image build and bind them to the resulting artifact. Manifest creation for an archived image must use that original metadata and reject mismatches, rather than report the current checkout or hardcoded dependency identifiers. Cover archived-image and mismatched-metadata cases.

## Transport completion and cleanup

- [ ] **NET-01 — Add read-only operation outcome queries.** Implement the specified `operation_query` codec, authorization, bounded retention and result path. Querying an uncertain command must never re-execute it or require admission of a new positive operation. Current code: [wire registry](../components/consortium/include/amity/consortium/wire.hpp). Contract: [08 — Transport and routing](08-consortium-transport-and-routing.md).
- [ ] **NET-02 — Add explicit hold results.** Implement the specified `hold_result` path for exact-token acceptance, release, expiry and rejection. Exercise duplicate, stale-token and lost-result handling without allowing a hold to move to a new route.
- [ ] **NET-03 — Reserve transport capacity for cleanup.** Implement the specified bounded priorities for cancellation/release, plan/control, observations and bulk/trace traffic. Cover original-controller-to-actuator cleanup; members cannot originate input releases or user intents. Saturating bulk/control queues must not prevent cleanup admission; general local authority/liveness fences stop held work when TCP stalls, without per-button renewal traffic. Current code: [runtime queues](../components/consortium/runtime.cpp).

## Independent zone continuity

- [ ] **ZONE-02 — Narrow reconfiguration quiescence within one device.** Preserve disjoint sessions and holds on the same device when only another executable slice changes. Continue to fence/drain shared resources and changed bindings, with current revision acknowledgements before new positive work. The current implementation quiesces all sessions on a changed owner. Current code: [hub service](../components/amity_hub/hub_service.cpp). Contract: [11 — Configuration, storage and migration](11-config-storage-and-migration.md).

## Setup codes

- [ ] **UX-04 — Provide checksummed manual setup codes.** Implement the specified manual/base32 presentation and validation, including malformed-code and transcription-error cases, while preserving the setup secret's entropy and security boundary. Define compatibility with existing development codes. Current code: [provisioning tool](../tools/consortium_provision.py). Contract: [09 — Membership, security and enrollment](09-membership-security-and-enrollment.md).
- [ ] **UX-05 — Generate the Add-code QR and printable card.** Produce the QR/card and equivalent manual entry from the same provisioned identity and secret. Verify round-trip decoding and keep setup secrets out of logs and public artifacts. Use provisional customer vocabulary: **Amity device**, **HDMI adapter**, **Amity system**; internal development terms must not appear in the UI or customer documentation.

## Production process and nonphysical release gates

- [ ] **PROD-01 — Define and approve the production workflow.** Document key custody, manufacturing, authorized signing, verification-key rotation, rollback/recovery policy and operator instructions. Keep development and production claims explicit. The existing offline preparation tools do not constitute an approved manufacturing or recovery process. Physical provisioning and recovery drills remain separate evidence requirements. Contracts: [14 — OTA](14-ota-and-compatibility.md), [17 — G12](17-decisions-and-open-questions.md).
- [ ] **PROD-02 — Complete publisher-verifier evidence and security review.** Add fixed valid, malformed, altered-image and wrong-root signature vectors exercising the actual PSA publisher-verification path, then record review findings and their resolution. This complements existing manifest/parser tests and hardware security qualification.
- [ ] **VAL-01 — Close browser and usability evidence gaps.** Record supported-browser, assistive-technology and novice-journey results against UX-01 through UX-16 in document 20. Validate the documented first-browser trust procedure and manual code entry when camera access is unavailable. Turn concrete defects discovered during validation into implementation tasks. Automatic browser certificate trust is not an implicit v1 requirement; [document 12](12-control-surfaces-and-admin.md) permits the documented local trust step. Real-hardware portions remain physical qualification.

## Supported limits and deferred scope

The current profile permits **three active devices**, one remote on the original controller, no hosted UI/integrations on added devices, and one primary Matter/HomeKit zone. These are explicit limits, not unchecked implementation tasks. Expanding toward eight active devices would require transport, socket, memory, storage, cohort-update and backup capacity work followed by qualification.

Controller promotion/handover, election, standby-controller or automatic failover are **outside scope and not planned work**. If the main is absent, headless members preserve isolation, release/expire exact held work and wait for that same main. Historical transfer state is passive recovery data only. ARC/eARC, built-in TV applications, direct peer actuation, additional external integration zones, transparent fabric/bond migration, Wi-Fi mesh and network video remain [separately deferred](17-decisions-and-open-questions.md). They are not required to close this checklist. Restart resumption continues to require fresh explicit intent.
