retsyx/amity-esp32/hw/tentacle/hdmi.kicad_pcb

## KiCad design hw/tentacle/hdmi.kicad_pcb (2026-11-08)

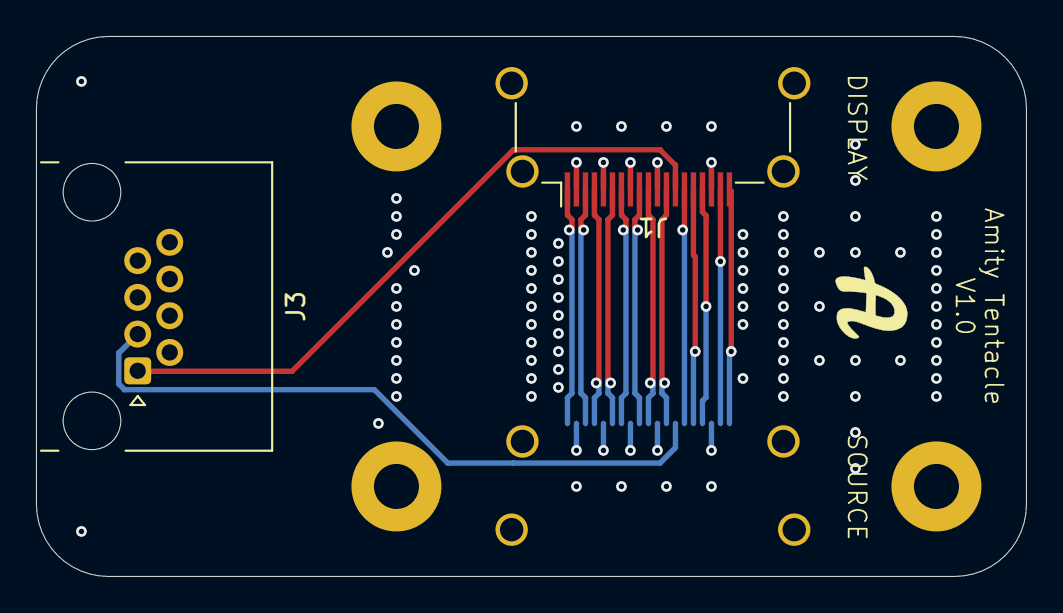
[picture p3: board hw/tentacle/hdmi.kicad_pcb from above]

Board: 4 copper layers, 55.0 x 30.0 mm, 7 parts (1 on the bottom side), 16 nets.

Parts:
H1, H2, H3, H4: MountingHole_2.5mm_Pad
J1, J2: HDMI_A; HDMI_A_Amphenol_10029449-x01xLF_Horizontal
J3: RJ45; RJ45_Pulse_E5J88-00LJG2-L_Horizontal_EdgeMount

Connections:
/CK+: J1.10 (CK+), J2.10 (CK+)
/CK-: J1.12 (CK-), J2.12 (CK-)
/D0+: J1.7 (D0+), J2.7 (D0+)
/D0-: J1.9 (D0-), J2.9 (D0-)
/D1+: J1.4 (D1+), J2.4 (D1+)
/D1-: J1.6 (D1-), J2.6 (D1-)
/D2+: J1.1 (D2+), J2.1 (D2+)
/D2-: J1.3 (D2-), J2.3 (D2-)
GND: H1.1 (1_1), H2.1 (1_1), H3.1 (1_1), H4.1 (1_1), J1.2 (D2S), J1.5 (D1S), J1.8 (D0S), J1.11 (CKS), J1.17 (GND), J1.SH, J2.2 (D2S), J2.5 (D1S), J2.8 (D0S), J2.11 (CKS), J2.17 (GND), J2.SH, J3.2, J3.4, J3.5, J3.6, J3.7, J3.8
unnamed: J1.18 (+5V), J2.18 (+5V)
unnamed: J1.13 (CEC), J3.1
unnamed: J1.19 (HPD), J2.19 (HPD)
unnamed: J1.15 (SCL), J2.15 (SCL)
unnamed: J1.16 (SDA), J2.16 (SDA)
unnamed: J1.14 (UTILITY), J2.14 (UTILITY)
unnamed: J2.13 (CEC), J3.3
