retsyx/amity-esp32/hw/octopus/hdmi.kicad_pcb

## KiCad design hw/octopus/hdmi.kicad_pcb (2026-11-07)

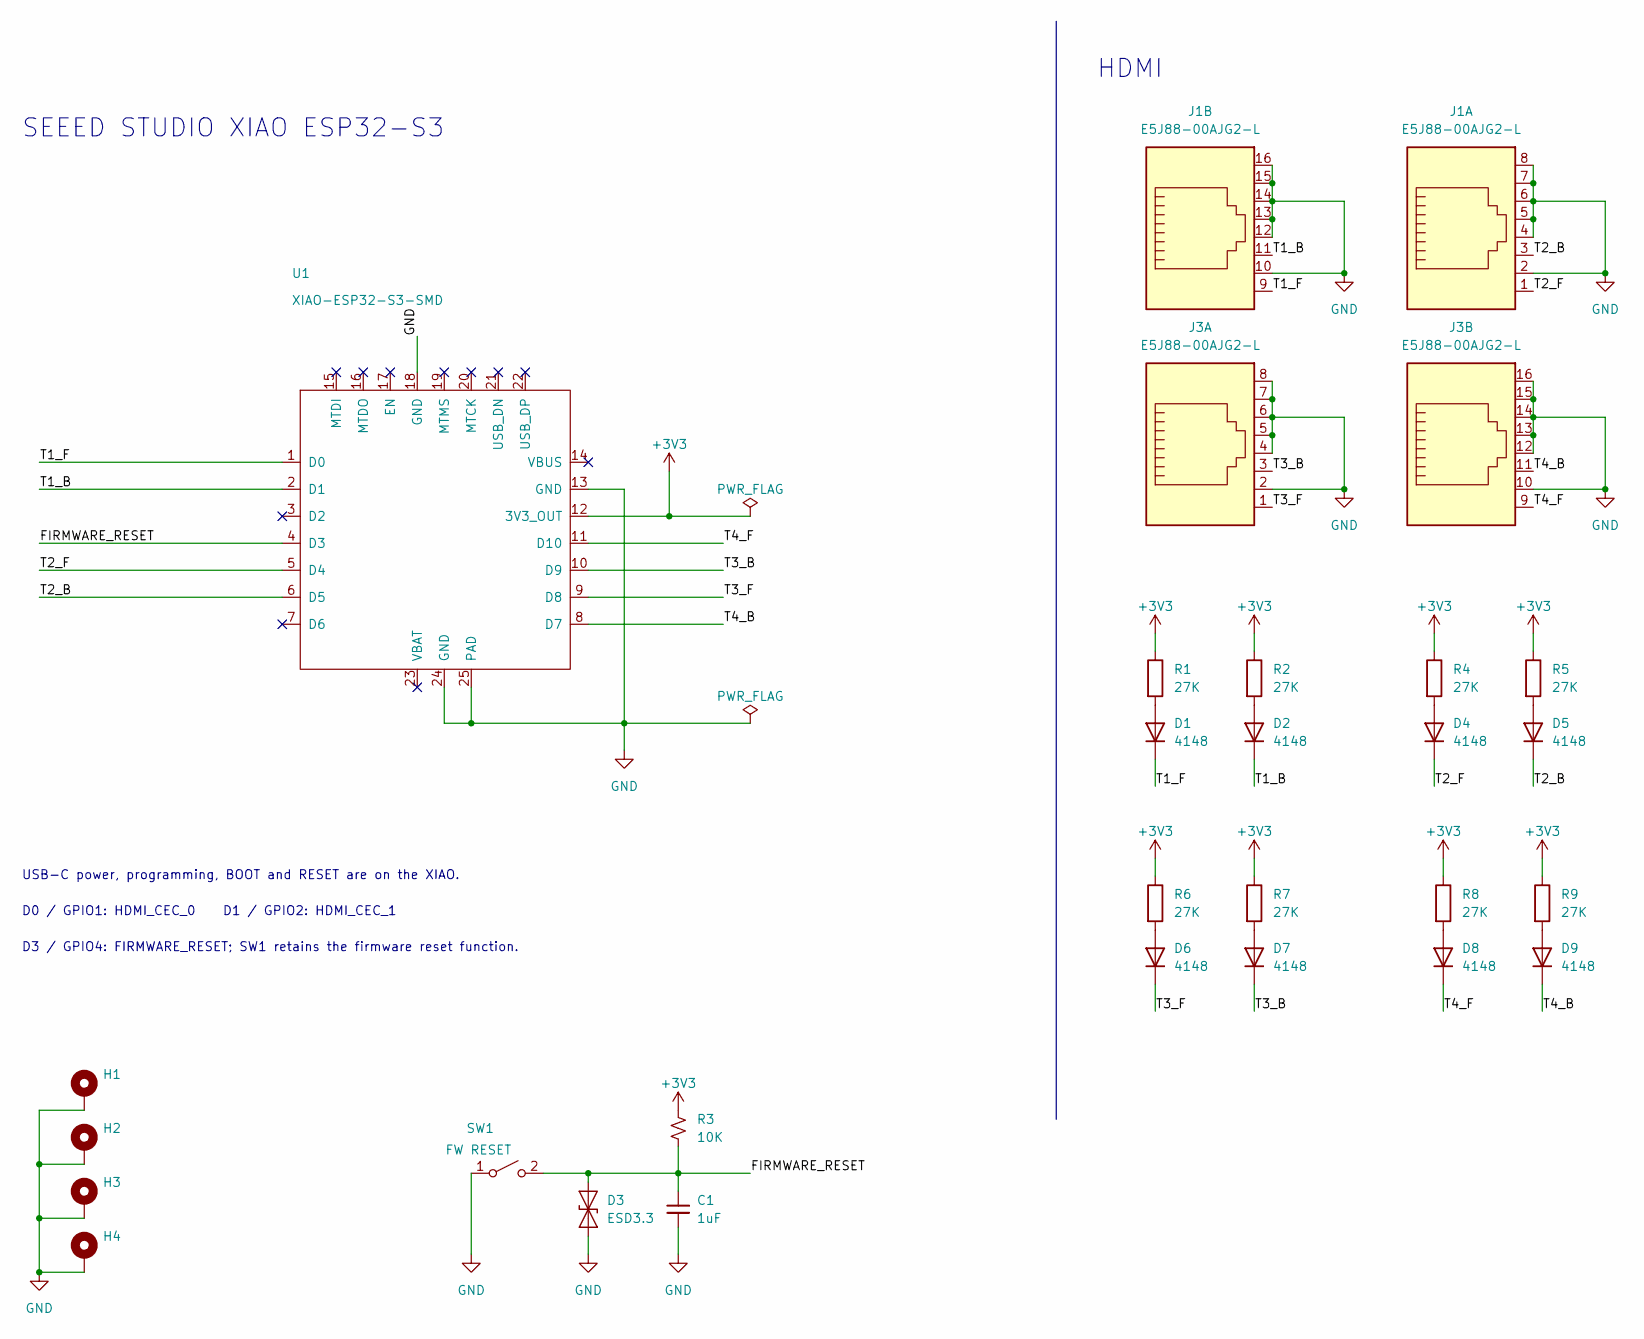
[picture p4: schematic hdmi.kicad_sch, Amity ESP32]

Parts:
C1: 1uF; C_0603_1608Metric; Tolerance 10%; Voltage Rating 16 V; MPN C1608X7R1C105K080AC
D1, D2, D4, D5, D6, D7, D8, D9: 4148; D_0603_1608Metric; MPN TS4148 RCG
D3: ESD3.3; D_SOD-923; MPN ESD9B3.3ST5G
H1, H2, H3, H4: MountingHole_2.5mm_Pad
J1, J3: E5J88-00AJG2-L; RJ45_Pulse_E5J88-00AJG2-L_Horizontal_EdgeMount
R1, R2, R4, R5, R6, R7, R8, R9: 27K; R_0603_1608Metric; Tolerance 5%; Power Rating 0.1 W; MPN CR0603-JW-273ELF
R3: 10K; R_0603_1608Metric; Tolerance 1%; Power Rating 0.1 W; MPN CR0603-FX-1002ELF
SW1: FW RESET; SW_SPST_B3U-1000P; MPN B3U-1000P
U1: XIAO-ESP32-S3-SMD; MPN 113991114

Connections:
+3V3: R1.1, R2.1, R3.1, R4.1, R5.1, R6.1, R7.1, R8.1, R9.1, U1.12 (3V3_OUT)
/FIRMWARE_RESET: C1.1, D3.2 (A2), R3.2, SW1.2 (B), U1.4 (D3)
/T1_B: D2.1 (K), J1.11, U1.2 (D1)
/T1_F: D1.1 (K), J1.9, U1.1 (D0)
/T2_B: D5.1 (K), J1.3, U1.6 (D5)
/T2_F: D4.1 (K), J1.1, U1.5 (D4)
/T3_B: D7.1 (K), J3.3, U1.10 (D9)
/T3_F: D6.1 (K), J3.1, U1.9 (D8)
/T4_B: D9.1 (K), J3.11, U1.8 (D7)
/T4_F: D8.1 (K), J3.9, U1.11 (D10)
GND: C1.2, D3.1 (A1), H1.1 (1_1), H2.1 (1_1), H3.1 (1_1), H4.1 (1_1), J1.2, J1.4, J1.5, J1.6, J1.7, J1.8, J1.10, J1.12, J1.13, J1.14, J1.15, J1.16, J3.2, J3.4, J3.5, J3.6, J3.7, J3.8, J3.10, J3.12, J3.13, J3.14, J3.15, J3.16, SW1.1 (A), U1.13 (GND), U1.18 (GND), U1.24 (GND), U1.25 (PAD)
unnamed: D1.2 (A), R1.2
unnamed: D2.2 (A), R2.2
unnamed: D4.2 (A), R4.2
unnamed: D5.2 (A), R5.2
unnamed: D6.2 (A), R6.2
unnamed: D7.2 (A), R7.2
unnamed: D8.2 (A), R8.2
unnamed: D9.2 (A), R9.2

Notes on the sheet:
HDMI
D3 / GPIO4: FIRMWARE_RESET; SW1 retains the firmware reset function.
SEEED STUDIO XIAO ESP32-S3
D0 / GPIO1: HDMI_CEC_0 D1 / GPIO2: HDMI_CEC_1
USB-C power, programming, BOOT and RESET are on the XIAO.

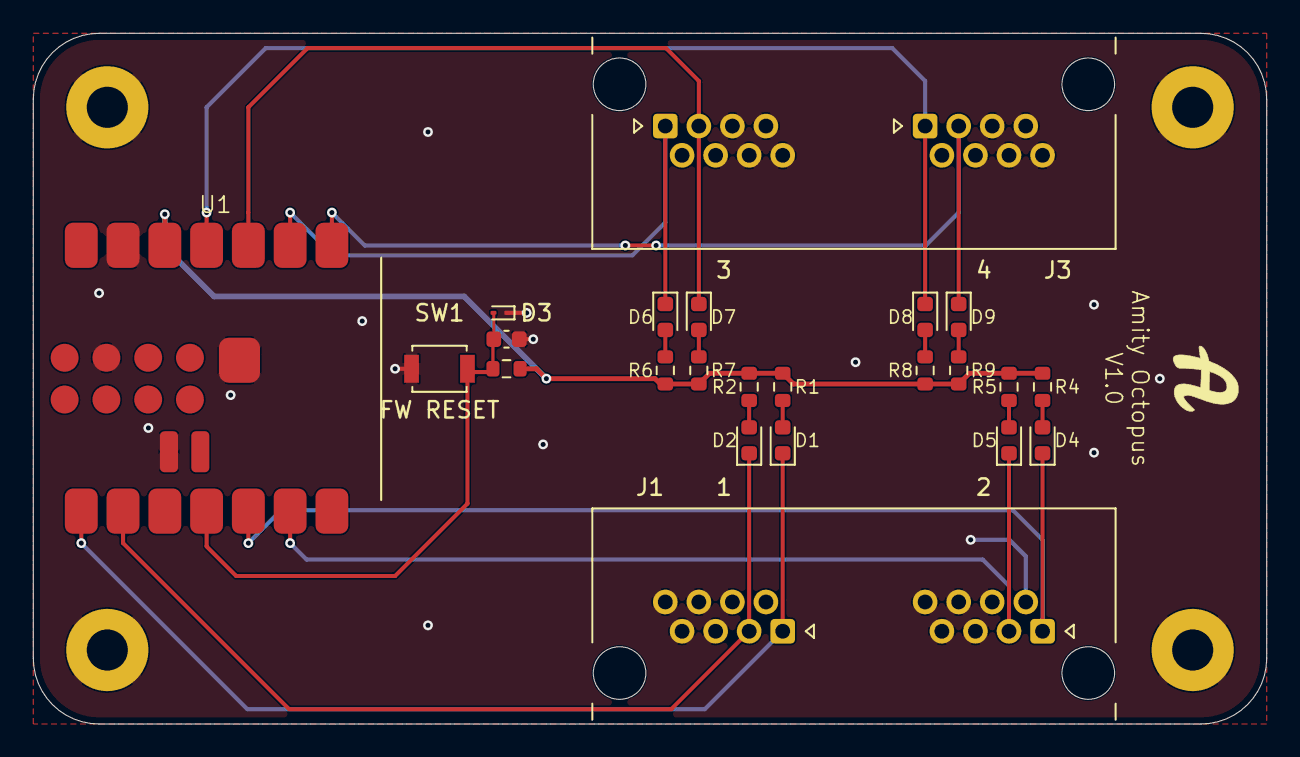
[picture p5: board hw/octopus/hdmi.kicad_pcb from above]

Board: 2 copper layers, 75.0 x 42.0 mm, 27 parts (0 on the bottom side), 19 nets.
