retsyx/amity-esp32/hw/testbed/testbed.kicad_pcb

## KiCad design hw/testbed/testbed.kicad_pcb (2026-11-07)

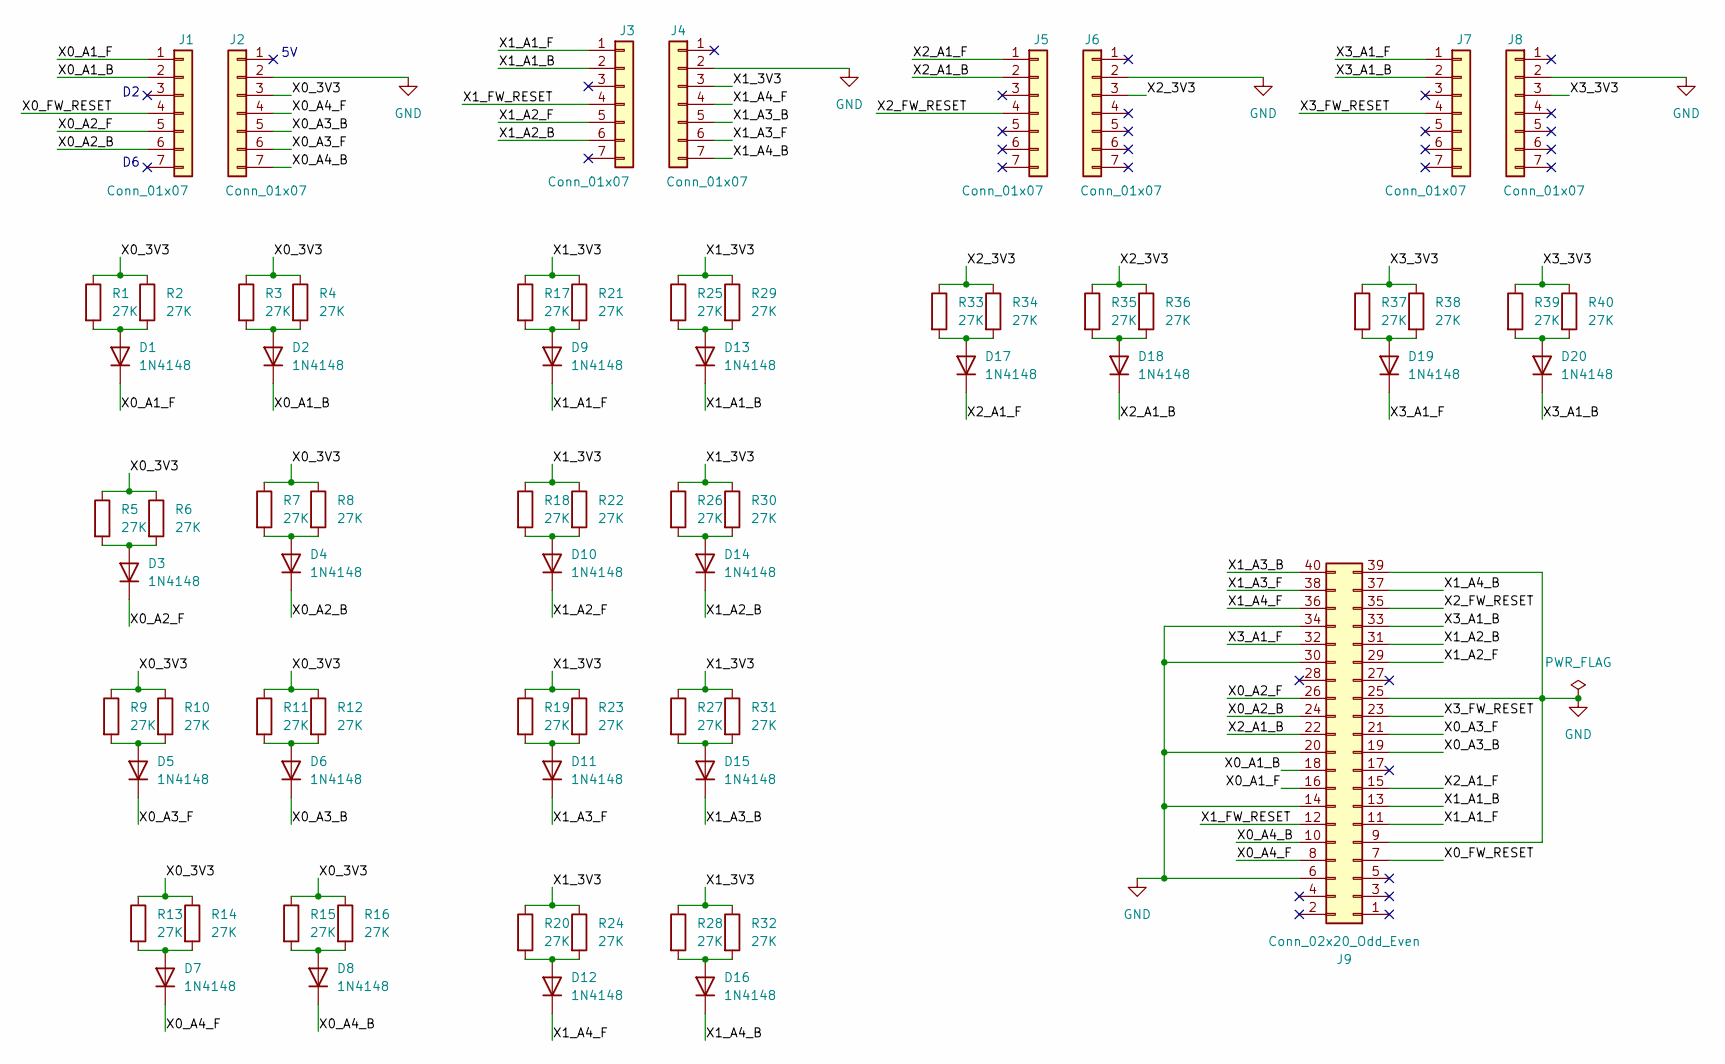
[picture p6: schematic testbed.kicad_sch]

Parts:
D1, D2, D3, D4, D5, D6, D7, D8, D9, D10, D11, D12, D13, D14, D15, D16, D17, D18, D19, D20: 1N4148; D_DO-35_SOD27_P7.62mm_Horizontal
J1, J2, J3, J4, J5, J6, J7, J8: Conn_01x07; PinSocket_1x07_P2.54mm_Vertical
J9: Conn_02x20_Odd_Even; PinSocket_2x20_P2.54mm_Vertical
R1, R2, R3, R4, R5, R6, R7, R8, R9, R10, R11, R12, R13, R14, R15, R16, R17, R18, R19, R20, R21, R22, R23, R24, R25, R26, R27, R28, R29, R30, R31, R32, R33, R34, R35, R36, R37, R38, R39, R40: 27K; R_Axial_DIN0207_L6.3mm_D2.5mm_P7.62mm_Horizontal

Connections:
/X0_3V3: J2.3, R1.1, R2.1, R3.1, R4.1, R5.1, R6.1, R7.1, R8.1, R9.1, R10.1, R11.1, R12.1, R13.1, R14.1, R15.1, R16.1
/X0_A1_B: D2.1 (K), J1.2, J9.18
/X0_A1_F: D1.1 (K), J1.1, J9.16
/X0_A2_B: D4.1 (K), J1.6, J9.24
/X0_A2_F: D3.1 (K), J1.5, J9.26
/X0_A3_B: D6.1 (K), J2.5, J9.19
/X0_A3_F: D5.1 (K), J2.6, J9.21
/X0_A4_B: D8.1 (K), J2.7, J9.10
/X0_A4_F: D7.1 (K), J2.4, J9.8
/X0_FW_RESET: J1.4, J9.7
/X1_3V3: J4.3, R17.1, R18.1, R19.1, R20.1, R21.1, R22.1, R23.1, R24.1, R25.1, R26.1, R27.1, R28.1, R29.1, R30.1, R31.1, R32.1
/X1_A1_B: D13.1 (K), J3.2, J9.13
/X1_A1_F: D9.1 (K), J3.1, J9.11
/X1_A2_B: D14.1 (K), J3.6, J9.31
/X1_A2_F: D10.1 (K), J3.5, J9.29
/X1_A3_B: D15.1 (K), J4.5, J9.40
/X1_A3_F: D11.1 (K), J4.6, J9.38
/X1_A4_B: D16.1 (K), J4.7, J9.37
/X1_A4_F: D12.1 (K), J4.4, J9.36
/X1_FW_RESET: J3.4, J9.12
/X2_3V3: J6.3, R33.1, R34.1, R35.1, R36.1
/X2_A1_B: D18.1 (K), J5.2, J9.22
/X2_A1_F: D17.1 (K), J5.1, J9.15
/X2_FW_RESET: J5.4, J9.35
/X3_3V3: J8.3, R37.1, R38.1, R39.1, R40.1
/X3_A1_B: D20.1 (K), J7.2, J9.33
/X3_A1_F: D19.1 (K), J7.1, J9.32
/X3_FW_RESET: J7.4, J9.23
GND: J2.2, J4.2, J6.2, J8.2, J9.6, J9.9, J9.14, J9.20, J9.25, J9.30, J9.34, J9.39
unnamed: D1.2 (A), R1.2, R2.2
unnamed: D2.2 (A), R3.2, R4.2
unnamed: D3.2 (A), R5.2, R6.2
unnamed: D4.2 (A), R7.2, R8.2
unnamed: D5.2 (A), R9.2, R10.2
unnamed: D6.2 (A), R11.2, R12.2
unnamed: D7.2 (A), R13.2, R14.2
unnamed: D8.2 (A), R15.2, R16.2
unnamed: D9.2 (A), R17.2, R21.2
unnamed: D10.2 (A), R18.2, R22.2
unnamed: D11.2 (A), R19.2, R23.2
unnamed: D12.2 (A), R20.2, R24.2
unnamed: D13.2 (A), R25.2, R29.2
unnamed: D14.2 (A), R26.2, R30.2
unnamed: D15.2 (A), R27.2, R31.2
unnamed: D16.2 (A), R28.2, R32.2
unnamed: D17.2 (A), R33.2, R34.2
unnamed: D18.2 (A), R35.2, R36.2
unnamed: D19.2 (A), R37.2, R38.2
unnamed: D20.2 (A), R39.2, R40.2

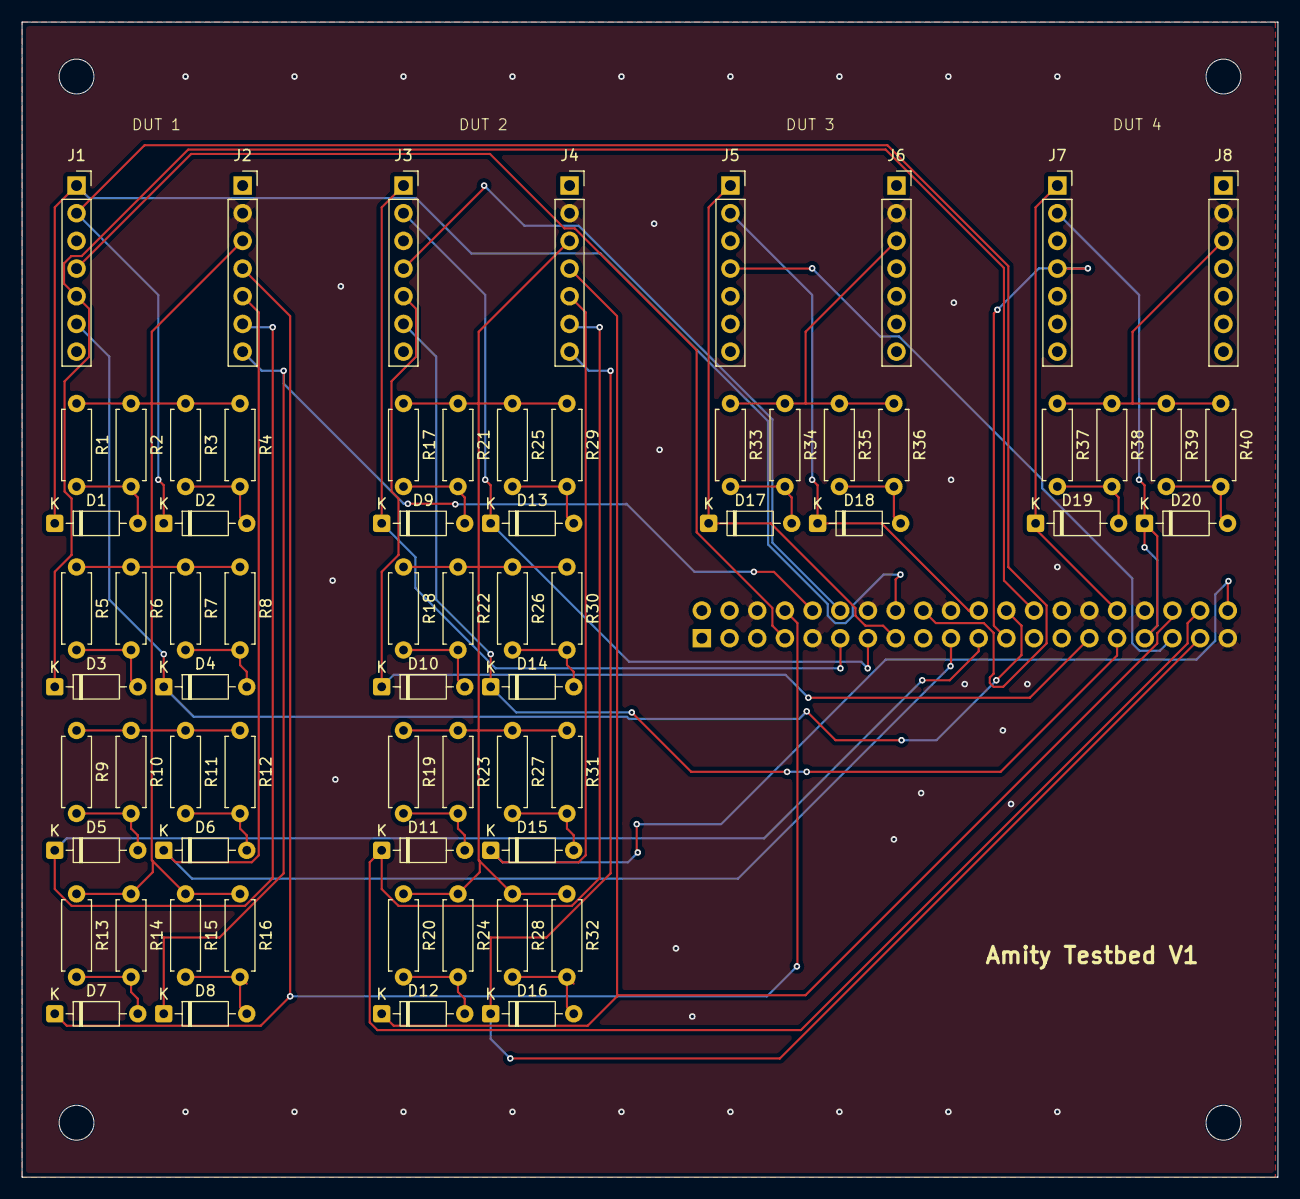
[picture p7: board testbed.kicad_pcb from above]

Board: 2 copper layers, 115.2 x 106.0 mm, 73 parts (1 on the bottom side), 49 nets.

Other parts of the board:
H1, H2, H3, H4: MountingHole_3.2mm_M3
