retsyx/amity-esp32/components/amity_hub/live_system.cpp

#include "amity/live_system.hpp"
#include "coordinator_intent.hpp"
#include <limits>
#ifdef ESP_PLATFORM
#include "esp_heap_caps.h"
#include <cstdlib>
#endif

namespace amity {
using namespace system;
#ifdef ESP_PLATFORM
void* LiveSystem::operator new(size_t size) {
    auto* p = heap_caps_malloc(size, MALLOC_CAP_INTERNAL | MALLOC_CAP_8BIT); if (!p) std::abort(); return p;
}
void LiveSystem::operator delete(void* p) { heap_caps_free(p); }
#endif
LiveSystem::LiveSystem(ConsortiumId group, OctopusId owner, BootId boot, std::function<bool(uint8_t*, size_t)> random, uint64_t epoch)
    : random_(std::move(random)), consortium_(group), octopus_(owner), boot_(boot), epoch_(epoch), coordinator_(random_) {}
void LiveSystem::attach(CecPortRef key, cec::Bus& bus, uint8_t identity, uint16_t physical) {
    if (key.tentacle_id >= amity::max_tentacles || ports_.size() >= amity::max_cec_ports || port(key)) return;
    const auto index = ports_.size();
    ports_.push_back({key, &bus, identity, physical, &wire_generations_[index], {}, {}, {}, false, 0, 0});
    ports_.back().slot_index = index;
    coordinator_.set_wire_adapter(key,
        [this,key](const WireWork* batch,size_t count){auto* p=port(key);return p&&submit_wire(*p,batch,count);},
        [this,key](uint64_t id){if(auto* p=port(key))cancel_wire(*p,id);});
}
std::pair<std::optional<uint16_t>, std::optional<uint16_t>> LiveSystem::front_physical_addresses(uint8_t id) const {
    auto front = std::find_if(ports_.begin(), ports_.end(), [&](const auto& p) { return p.key.tentacle_id == id && p.key.side == Side::front; });
    if (front == ports_.end() || !front->present) return {};
    std::optional<FullyQualifiedCecAddress> reporter;
    for (const auto& p : config_.port_templates) if (p.port == front->key && p.physical_address &&
        p.physical_address->provenance == PaProvenance::immediate_peer_report) reporter = p.physical_address->reporter;
    std::optional<uint16_t> observed;
    size_t reporters = 0;
    for (const auto& back : ports_) if (back.key.tentacle_id == id && back.key.side == Side::back && back.present && back.verified && back.verified->status == ScanStatus::complete)
        for (const auto& observation : back.verified->observations) if (observation.endpoint.port == back.key &&
            observation.kind == ObservationKind::native_appliance && observation.owner_boot_id == boot_ && !observation.stale &&
            observation.device_type != 0xff && valid_physical_address(observation.physical_address, false) &&
            observation.received_at_ms <= last_tick_ms_ && last_tick_ms_ - observation.received_at_ms <= 30000 &&
            (!reporter || observation.endpoint == *reporter)) {
            ++reporters; observed = observation.physical_address;
        }
    if (reporters != 1) observed.reset();
    const auto selected = observed ? observed : valid_physical_address(front->physical) ? std::optional<uint16_t>{front->physical} : std::optional<uint16_t>{};
    return {observed, selected};
}
void LiveSystem::set_tentacle_present(uint8_t id, bool present, uint64_t now) {
    if (id >= amity::max_tentacles) return;
    bool changed = false;
    for (auto& p : ports_) if (p.key.tentacle_id == id && p.present != present) {
        changed = true; p.present = present; ++*p.wire_generation;
        p.bus->install_receive_policy({true, 15}); p.identity = 15;
        if (p.scan) discovery_.cancel_scan(p.scan);
        p.scan = {}; p.verified_scan = {}; p.verified.reset(); p.claiming = false; p.probe.reset(); p.allocation_probe = false;
        p.claim_index = p.vacant_polls = 0; p.next_claim_ms = now;
        for (auto& policy : config_.port_templates) if (policy.port == p.key) {
            policy.owned_logical_address.reset();
            p.claiming = present && (policy.role == PortRole::tv_controller || policy.role == PortRole::playback_proxy);
        }
        observations_.erase(std::remove_if(observations_.begin(), observations_.end(), [&](const auto& o) { return o.endpoint.port == p.key; }), observations_.end());
    }
    if (!changed || !configured_) return;
    std::vector<std::pair<SessionId, uint64_t>> affected;
    for (const auto& policy : coordinator_.policies()) if (policy.port.tentacle_id == id)
        for (const auto& grant : policy.route_grants) affected.emplace_back(grant.session_id, grant.route_generation);
    if (!present) {
        for (size_t i = 0; i < guard_count_; ++i)
            for (const auto& binding : bindings_) if (binding.binding_id == binding_guards_[i].id && binding.endpoint.port.tentacle_id == id) ++binding_guards_[i].generation;
        for (const auto& route : affected) coordinator_.fence_remote_route(route.first, route.second);
    }
    // Binding withdrawal cancels unsafe old-target cleanup. Returning hardware
    // must collect fresh names/addresses and cannot recreate the lost session.
    if (!resolve(now, false, error_)) { error_ = "HDMI attachment synchronization failed: " + error_; resolving_ = true; }
    if (!present) for (const auto& session : coordinator_.snapshot().sessions)
        if (std::any_of(affected.begin(), affected.end(), [&](const auto& route) { return route.first == session.session_id; })) {
            coordinator_.stop(session.zone_id, now);
            if (session.zone_id == config_.primary_zone_id) { selected_slot_ = -1; held_.fill({}); ++activity_generation_; }
        }
    next_discovery_ms_ = now;
}
LiveSystem::Port* LiveSystem::port(const CecPortRef& key) { for (auto& p : ports_) if (p.key == key) return &p; return nullptr; }
bool LiveSystem::preserves_configuration(const LocalConfiguration& config) const {
    return configured_ && config.executable_hash == config_.executable_hash && config.topology.config_revision >= config_.topology.config_revision &&
        config.member == config_.member && config.coordinator_id == config_.coordinator_id && config.coordinator_epoch == config_.coordinator_epoch;
}
bool LiveSystem::revision_rebase_ready(const LocalConfiguration& config) const {
    return preserves_configuration(config) && (config.topology.config_revision == config_.topology.config_revision || coordinator_.can_rebase_revision(config.topology.config_revision));
}
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
