retsyx/amity-esp32/components/amity_hub/include/amity/hub.hpp

/*
 * Copyright 2026.
 * This file is part of Amity-esp32.
 * Amity-esp32 is free software: you can redistribute it and/or modify it under the terms of the
 * GNU General Public License as published by the Free Software Foundation, either version 3 of the
 * License, or (at your option) any later version.
 */

#pragma once
#include "cec/engine.hpp"
#include "amity/system/owned_intent.hpp"
#include "amity/system/execution.hpp"
#include <functional>
#include <cstdint>
#include <string>
#include <vector>

namespace amity {
enum class BusSide : uint8_t { Front, Back };
struct Activity {
    std::string name, display, source, audio, switch_device;
    uint8_t switch_input = 0;
    system::ActivityId activity_id{};
    bool operator==(const Activity& other)const{return name==other.name&&display==other.display&&source==other.source&&audio==other.audio&&switch_device==other.switch_device&&switch_input==other.switch_input&&activity_id==other.activity_id;}
};
struct Device {
    std::string name;
    BusSide bus = BusSide::Back;
    uint8_t address = 15;
    uint16_t physical_address = 0xffff;
    uint8_t type = 0xff;
    uint32_t vendor_id = 0;
    // The original owner-local cache has a name for this appliance.
    bool resolved = false;
    bool operator==(const Device& other)const{return name==other.name&&bus==other.bus&&address==other.address&&physical_address==other.physical_address&&type==other.type&&vendor_id==other.vendor_id&&resolved==other.resolved;}
};
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
