retsyx/amity-esp32/(commit log)

2026-10-06 Initial board design with ESP32_S3 WROOM board.
2026-10-07 XIAO ESP32-S3 based board
2026-10-21 Drop CEC release overflow slot and log full FIFO drops
2026-10-22 Apply reviewed UI refinements to consortium administration
    Port aa9395a while preserving the Amity devices tab, per-adapter settings, and scoped activity workflows. Update the presentation contract and exact HTML baseline guard, and advance firmware to 0.1.79.
    Validated with host and provisioning checks, all three browser suites, and desktop/mobile layout checks.
2026-10-23 Port HomeKit and HTTP security fixes to consort
    Apply main security fixes f0efe2d and device-probe correction 71baf15. Preserve signed OTA admission, image verification, maintenance hooks and update reporting while bounding metadata and image reads. Retain HomeKit service-stop fencing around unlocked body reads and close rejected consortium API requests without draining their bodies.
    Include sanitizer regressions, signed-upload deadline checks and hardware probes. Full host suite and ESP-IDF development build pass. Bump firmware to 0.1.80.
2026-10-27 Centralize hardware limits and support up to four tentacles
    Keep the single-adapter board as the default and provide XIAO GPIO pairs
    1/2, 5/6, 7/8 and 9/44 for the optional four-adapter profile. Remove the
    fifth connector from runtime, settings, protocol validation and schemas.
    Derive firmware bounds and arrays from one shared hardware limit, read the
    same value in release tooling, and check Menuconfig/schema consistency in
    the host runner. Preserve supported addresses when reading older settings
    records and keep CEC and input algorithms unchanged.
    Validation: ESP32-S3 firmware build, focused ASan/UBSan suites, actual
    Kconfig/generated-profile and release-identity checks, and 361 settings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
2026-10-27 Replace consortium planner with qualified owner lookup
    Store original activity intent and resolve device, HDMI adapter, CEC side and OSD name at the owner. Remove persistent enablement, topology approvals, prepared plans, owner replicas and activity-resume tracking.
    Preserve original local activity and CEC behavior across owners, retain migration intent, and simplify the design contracts and documentation. Record the architectural lesson in AGENTS.md.
2026-10-29 Replace static harness with Python functional framework
    Remove fixed virtual-device setup and previous harness scripts. Add
    configurable DUT and component models, virtual CEC routing, topology address
    assignment, and a shared functional runner using existing authenticated UI APIs.
    Read bench wiring implicitly, keep one concise HDMI scan scenario, and document
    interactive Python use on the Pi. Run framework unit checks from the host suite.
    Validation: 97 framework unit tests pass; the physical HDMI scan passed on
    amity-dut with CEC transport on test2.
2026-10-29 Model harness HDMI attachments and assert exact scan connections
2026-10-29 Add activity lifecycle functional test with physical power assertions
2026-10-29 Preserve standby stack headroom and borrow owner intents
    Give the shared hub task 12 KiB for nested local ownership dispatch. Borrow
    intents synchronously while queued commands and held-key state own copies,
    and cover start/standby parity plus queued request lifetime.
    Record the prior native/physical validation and current preservation
    instructions. The full host runner and 0.1.88 working-tree firmware build
    passed with these changes included.
2026-10-29 Record amity-dut 0.1.88 update and reset verification
    Record the authenticated update, legacy configuration rejection, explicit
    factory reset and user-confirmed Matter re-enrollment. Verify the retained
    device identity, expected image, ready original-main UI, factory admin login
    and user-restored hostname after reboot.
    Keep physical CEC/radio behavior qualification separate. Document private
    credential consolidation without publishing credentials or checking in case
    assets. Contract validation and documentation whitespace checks pass.
2026-10-29 Add two-player source theft functional test
    Support explicit playback address profiles and CEC 1.4 allocation for the shared three-device back bus, with physical routing assertions and safe cleanup.
    Validated with 204 framework tests and all three functional scenarios on test2; a fresh source-theft rerun also passed.
2026-10-29 Add Amity admission functional test and parsed GPIO control
    Exercise existing authenticated scan/add/remove UI operations with a
    control-only candidate and exact device/boot ownership fences. Use bounded
    Pi-owned GPIO holds and Markdown-derived pin fixtures, and record
    sanitized request timelines and cleanup evidence.
    Validation: 238 framework unit tests and full contract validation pass.
    Physical Add remains failing: the 0.1.84 candidate's fw_reset task
    overflowed before discovery; no Add or Remove was submitted.
2026-10-29 Test activity switch input selection
2026-10-30 Add consortium functional test and preserve live device handling
2026-10-30 Add stdio tracing to the functional test framework
2026-10-30 Preserve live lookup results and trace exact ownership and link failures
2026-10-30 Bound application TLS writes to reduce internal DMA memory demand
2026-10-30 Trace enrollment phases with bounded setup timing logs
2026-10-30 Record all-DUT latency fixes and seven-case physical validation
2026-11-01 Add four-DUT consortium coverage and allow three secondaries
    Exercise amity-dut with amity-dut-2, amity-dut-3 and amity-dut-4 through exact
    discovery, activity power cycles and all twelve source-theft directions.
    Register the scenario independently and in --test all, preserving reverse-order
    cleanup.
    Use one shared three-secondary limit for admission, credentials, TLS, runtime
    links, adapter observations and advertised capacity. Preserve pending setup
    completion metadata when deferred configuration context is freshly recaptured.
    Validation: the full host suite (365 framework tests), ESP32-S3 build and all
    eight physical functional cases pass on exact firmware 0.1.115 with simulated
    CEC equ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
2026-11-02 Keep activity execution local and route bounded key edges by owner
    Make the authenticated key API complete each tap or bounded 0..5000 ms hold.
    The main retains only a recipient Amity index per raw key; owners resolve
    presses, local continuations and releases from their current activity.
    Replace renewable input grants, hold tokens, generic replay IDs and global
    CEC step coordination with ordered raw key edges and shared activity intent.
    Keep owner-local lookup and transmit sequencing, and invalidate old user
    input before a newly accepted activity starts. Preserve boot, configuration,
    authority and administrative retry fences.
    Fix lifecycle ACK draining and reduce replicated key state so al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
2026-11-02 Expand functional coverage and bound CEC interrupt latency
    Add physical regressions for same-activity repair, ordered display handoffs,
    owner-qualified duplicate equipment, missing-source cooldown and passive return,
    and bounded holds after an HTTP client disconnect. Preserve fresh wire evidence,
    owner/boot fences, cleanup receipts and exact scan membership.
    Bound SDK PSRAM cache writeback critical sections to 256 bytes after capturing
    a SHA flush that delayed the CEC timer. Retain numeric LineError diagnostics
    with immutable attempt results and add boot-fenced authenticated HTTP log capture.
    Keep announcement-triggered metadata queries distinct from enumeration.
    Validation: all 16 functio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
2026-11-02 Indicate functional harness runs with the Pi status LED
    Restore the original LEDs after the last overlapping run, including runner disconnects. Keep LED failures independent of test outcomes.
2026-11-02 Test member removal with referenced activity equipment
    Add a functional case with four saved activities independently selecting member
    source, display, audio and switch equipment. Reject an actually stale review,
    then confirm a fresh exact cascade while preserving unrelated activity rows,
    ordering, slot metadata and main adapter settings. Verify reset acknowledgement,
    name/settings purge and fresh execution of the surviving local activity.
    Keep normal fixture cleanup conservative. Explicit cascade removal tracks its
    original administrative request across uncertain outcomes, and reports retain
    review IDs, typed rejection and exact deletion/preservation proofs. Add unit
    coverage for ownership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
2026-11-03 Adjust activity dialog buttons and settings dismissal
2026-11-03 Deleted a couple README.md
2026-11-03 Track test keyboard bonds before HID discovery completes
2026-11-03 Apply per-Amity hostname settings without reboot
    Move hostname editing into each Amity device settings dialog. Store the
    hostname and its revision independently of adapter defaults, keeping
    octopus_id as the stable device identity. Update running network and
    service metadata and publish peer names over existing connections.
    Restore the standalone hardware capacity checks and replace optional
    JSON Schema comparisons with mandatory C++ parser boundary cases.
2026-11-03 Replace consortium heartbeats with TCP keepalive
    Remove heartbeat messages, payload schema, session handling, scheduling, and
    obsolete test fixtures. Enable TCP keepalive on both ends of each peer link
    with a 10-second idle delay, 3-second interval, and three probes.
    Build and flash version 0.1.132 to all four DUTs. All 24 functional cases
    passed across the full run and an unchanged four-DUT rerun after a harness
    SSH receive timeout. Protocol/TLS regressions and 627 harness unit tests
    also passed.
2026-11-03 Coordinate staged firmware updates across Amities
    Stage a single uploaded image on the primary and sequentially on its members before coordinated activation. Keep release information with each OTA partition and automatically update mismatched members from the primary's running image before application synchronization.
    Validate with the firmware build, host and browser suites, physical system update and catch-up checks, and all 24 existing functional scenarios. Rerun BLE scenarios using the documented Pi Python environment.
2026-11-03 Enroll factory-reset DUT through Pi Matter controller before tests
    Require factory state, provision Wi-Fi over Matter BLE on the Pi, and verify authenticated HTTP readiness. Reset and verify the main after successful runs while preserving failed runs for debugging.
    Add pinned controller setup, factory hostname inventory, enrollment-only validation, focused unit coverage, and operator documentation.
    Validation: 709 framework tests with one platform skip; 25 focused controller tests on the Pi; live enrollment, existing-main rejection, and final factory-reset verification.
2026-11-03 Add one-command Raspberry Pi harness setup
2026-11-03 Add hostname reboot coverage to regular functional tests
    Exercise local and distributed activities through main and secondary hostname
    changes and all requested reboot combinations. Verify persisted configuration,
    fresh physical commands and canonical-name restoration after successful cases.
    Use the main's authenticated UI operations for configuration and native USB
    control-line resets for secondary reboots. Retain failed DUT state for debugging
    and stop later scenarios; all boards can be factory reset after diagnosis.
    Validation: all 27 regular hardware scenarios passed, including the hostname
    matrix and final factory-reset verification. Unit suite: 786 run, 1 skipped.
2026-11-04 Fix BLE radio ownership and stream firmware updates
    Use committed Matter BLE disable intent and physical link teardown for radio
    availability, removing commissioning-state gates. Clear controller privacy
    entries during checked Unpair and use full scan windows under Wi-Fi coexistence.
    Stream update chunks through the existing bounded TLS FIFO without per-chunk
    replies or NVS progress checkpoints. Retain final image validation, stop the
    cohort on validation rejection, and restart interrupted transfers from zero.
    Validated with the ESP32-S3 build, host and provisioning checks, and main/member
    bench behavior. The 2,482,112-byte streamed transfer and validation took 85.05s;
    the full UI update t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
2026-11-04 Test activity retention through Amity replacement
    Exercise the shipping replacement preview and apply operations across different adapters, preserving exact saved activity and equipment identities before proving fresh CEC power, routing, key and standby control. Track confirmed replacement removal for fixture cleanup and keep hostname tests independent of the optional inventory column.
    Validation: 943 harness unit tests (one skipped); physical amity_replacement run including preparation, cleanup and factory-reset verification passed.
2026-11-04 Protect active activities during configuration edits
    Reject edits and deletion of the current activity while allowing other saved activities and their order to change without stopping playback. Preserve stable selection identity, input generations, held keys and discovery, with persistence outside the owner snapshot lock and stable-ID checks at selection admission.
    Extend the existing switch-input functional scenario to edit a local activity during member playback, verify rejected active changes and uninterrupted physical routing/keys, then exercise the saved new input.
    Validation: firmware 0.1.138 build; full host and provisioning suites; activity/component browser regressions; 954 harnes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
2026-11-04 Strengthen functional CEC transmission policy evidence
    Capture NACKs before a held stream starts, retain failures at every byte,
    and corroborate the main's press budget with fresh authenticated UI logs.
    Exercise eight FIFO admissions, exact dropped press diagnostics, and no
    replay through matching key-up and final owner reads.
    Validation: 1,023 unit tests (one skipped). All 38 ordinary functional
    scenarios ran: 35 passed, with three BLE setup failures. The corrected
    FIFO/NACK assertions passed on the harness; local BLE still hits the
    unchanged gate-window guard. Dedicated firmware upgrade passed on all
    four boards, including retained activities, cleanup and final factory reset.
2026-11-05 Test activity setup without state replies
    Suppress power, audio and source state reports while preserving discovery
    and physical CEC acknowledgements. Require fresh setup commands, activity
    readiness and subsequent Standby, with physical ACK evidence for the
    unanswered audio query and no transmitted state reports.
    Validation: all 39 functional scenarios passed on the harness, including
    commissioning and final factory reset (41 stages). The focused scenario
    and all 18 runner unit tests passed as well.
2026-11-05 Wait for playback status before enabling activity controls
    A newly opened UI could enable Start before its first status response, so an early selection lacked the boot identity required by the activity API. Keep activity controls locked until a valid boot and playback revision arrive, including revision zero, and clear stale state on entry and logout.
    Add a delayed-status browser regression and a focused --readiness-only mode. Bump firmware to 0.1.141.
    Validation: Pi readiness regression failed before the fix and passed afterward; firmware build, host checks (1042 framework tests, one skipped), and provisioning checks passed. The existing full browser script separately stops at its stale a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
2026-11-05 Increase bounded administration connection capacity
    Allow eight HTTP clients so one browser connection pool and an authenticated API client can coexist, including connection handoff. Raise the LWIP socket budget to 24 to retain room for the four-board consortium and other network services. Keep existing LRU behavior and request policy. Bump firmware to 0.1.142.
    The prior capacity reproduced Chromium connection resets during normal UI/API reads, including within seconds after a fresh boot. The candidate builds, flashes on all four DUTs, and returns ready owner settings. The controlled after-change probe and full mixed BLE/API soak remain pending at the user-requested pause.
2026-11-05 Add opt-in four-DUT UI and BLE endurance test
    Register --test soak outside default and all runs. Run the complete workload on the harness Pi for at least two hours after setup, with amity-dut heading all four boards, eight activities, real Chromium interaction, and alternating BLE/API navigation and volume taps and holds. Assert fresh physical power, routing, press and final-release evidence, owner boot/readiness, standby and rendered UI state. Collect no heap metrics.
    Add bounded browser diagnostics, generic timed BLE evidence, hardware-free scenario checks and an explicitly invoked real-browser workflow/cleanup regression using the shipping UI. Document Pi-only execution and optional Chro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
2026-11-05 Run functional tests entirely on the Raspberry Pi
    Provision a managed Python runtime with USB reboot and browser dependencies,
    native USB permissions, and readiness checks for the documented DUTs. Remove
    split-host execution and use the Pi's monotonic clock for physical wire evidence.
    Release the verification-only Matter commissioning fail-safe so consecutive
    factory-reset test runs can commission again.
2026-11-05 Test activity continuity through a member USB reboot
    Observe the current activity and original CEC frames throughout a member reboot,
    rejecting transient power, audio and routing interruptions. Verify the new member
    boot and unchanged main, configuration and settings before refreshing discovery
    proof for fresh key commands.
    Register the scenario as activity_member_reboot and retain failed DUT state for
    diagnostics. Cover stale boot proofs and hidden transient interruptions in unit
    tests.
2026-11-05 Test firmware transfers interrupted by DUT USB reboots
2026-11-05 Add four-DUT functional variants with the fourth board as main
2026-11-07 Initial testbed PCB
2026-11-07 Add Octopus and Tentacle PCBs
2026-11-07 Keep memory diagnostics from masking CEC interrupts
2026-11-07 Add more vias in the tentacle PCB
2026-11-07 Trace key release handoff and HTTP latency stages
2026-11-08 Reduce TCP loss recovery delay and trace release acknowledgments
2026-11-08 Round tentacle PCB corners
2026-11-08 Trace initial presses and one-shot key transfers
2026-11-08 Resume admitted UI operations after network interruptions
2026-11-08 Trace Wi-Fi driver drops and slow console output
2026-11-09 Trace completed network handoffs and outstanding driver calls
2026-11-10 Trace TCP timer progress during delayed key delivery
    Observe entry and completion of the existing lwIP timer without changing its scheduling or transport policy. Include cached progress and call-spacing evidence in already-qualified key ACK diagnostics. Cover first entries, held callbacks, wraparound, log suppression and bounded output in native tests.
2026-11-11 Reduce HTTPS packet pressure and fix AES DMA cleanup
2026-11-11 Reduce idle memory use and fix peer and log handling
    Publish configuration revisions after owner application and refresh HomeKit
    inputs only when their configuration changes. Recycle unused key-owner slots
    so replacing members cannot exhaust routing capacity.
    Reserve bounded TLS handshake capacity for reconnecting members at a full
    roster. Collect logs asynchronously with one worker and drain requests before
    HTTP shutdown. Compact CEC receive and completion storage, and move owner task
    state to PSRAM while retaining ISR guards in internal RAM.
    Validation: ESP32 firmware build, host regression checks, and 1,283 harness
    unit tests (three skipped). One unchanged harness timing test timed out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
2026-11-11 Transfer firmware as binary and verify images once at staging
    Bind raw image chunks to their accepted transfer on the authenticated stream. Reuse validated partition metadata for distribution and activation without repeated image hashes or native validation.
    Validated with firmware builds, the full host suite, 1296 harness unit tests, and the four-DUT firmware_upgrade functional scenario from 0.1.165 to 0.1.166, including interrupted transfers and physical activity checks.
2026-11-11 Run firmware host and browser tests in CI
    Run the host suite after the SDK-backed firmware build and all seven Playwright suites in a parallel job, gating releases on both. Reuse the harness Playwright pin and provision Node explicitly.
    Fix GCC portability errors in test fixtures and update the stale HomeKit browser fixture without changing assertions or firmware behavior.
2026-11-11 Remove the unscoped hub execution mode
    Only parity tests produced the non-scoped Configure command. Split Hub
    into the per-adapter resolver and CEC translator (Hub) and the single
    activity sequence that dispatches owner actions (ActivityHub). This
    removes the scoped_mode and owned_sender_ branches, HubService::configure
    and configure_with_commit, the local key-hold state and the unqualified
    name lookup.
    Owner execution starts passive and is enabled by scoped configuration or
    controller binding. Authority transitions reset owner key routing.
    Single-board tests configure through configure_scoped with qualified
    selectors. Mode-comparison tests become explicit frame expectations, and
    held-key,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
2026-11-11 Remove dead and vestigial code from the firmware
    Delete functions that compiled but were discarded by --gc-sections, plus
    lifecycle.cpp, which only tests referenced. Also drop state and branches
    that only these functions read or produced:
    - consortium: MembershipJournal/Roster, OperationalCredentialPolicy and
    check_release (lifecycle.cpp); the Security2 self-test and its vectors;
    EnrollmentWindow (keep its duration as enrollment_window_ms);
    FrameReader::next_frame; RadioArbiter setup-connection admission and
    SetupEligibility; runtime_send_control; wire parse_address/parse_name.
    - amity_hub: Hub::snapshot/update_snapshot/clear_devices and the
    write-only binding/uncertain-release co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
2026-11-11 Drop unreachable kind and payload handling from queue_control
    Its only callers now queue scoped intents and owner snapshots, which
    carry no payload. Remove the payload parameter and its size check, the
    redirect for firmware-update kinds and the retired-kind rejection.
    Tests that queued device-status packets through queue_control now use
    the traffic production queues: owner snapshots through
    runtime_send_owned_result, or scoped intents. The retired-kind check
    goes with its branch.
2026-11-12 Make remote battery updates no-ops while Matter is disabled
    Member Amities and mains whose original interfaces were retired run with
    Matter user services disabled by design. The shared background task still
    reported the remote battery every second, and amity_matter_update_remote
    treated the disabled controller as an error. Each member logged
    "Remote battery Matter update failed: ESP_ERR_INVALID_STATE" once per
    second, crowding real diagnostics out of the log ring.
    Treat a disabled controller as a successful no-op, matching
    amity_matter_update_state. An enabled controller that has not started
    still reports ESP_ERR_INVALID_STATE.
2026-11-12 Add a one-line USB firmware update for every harness DUT
    ./cec-harness/flash-duts PATH writes an OTA partition image
    (build/amity-partition.bin) to every DUT in TEST-HARNESS.md in parallel.
    It erases otadata and writes ota_0 only, so boards boot the new image
    while NVS, factory provisioning and Matter credentials stay unchanged.
    Update bundles and raw images are rejected. A failing board prints its
    esptool output and the command exits nonzero, without retry.
    Setup deploys the launcher and installs pinned esptool in the managed
    runtime, whose verification now imports it. The README gains a quick
    start covering flashing and running the tests.
2026-11-12 Bound setup step gaps in the silent-status activity test
    test_activity_without_status_replies accepted any start that settled
    within the 180 s operation timeout, so firmware that waited for each
    withheld report before continuing still passed. Require every gap
    between consecutive Amity frames during setup to stay within the CEC
    timeout.
2026-11-12 Check lookup scan scope and count
    Split theater never checked where its cache-miss lookup scanned, and
    assert_scan_on accepted any number of enumeration queries, so scanning
    extra sides or scanning twice inside the cooldown passed. assert_scan_on
    now requires exactly one Give Physical Address and Give OSD Name per
    device on the scanned side. The new LookupScans.assert_lookup_of
    requires one enumeration of an unwitnessed recipient and none on the
    witness wires; split theater uses it for the source lookup.
2026-11-12 Stop CEC workers under the session lock
    close() set the stop flag without the session lock while a worker could
    still be inside its final receive poll. A DUT query read in that window
    was delivered, the component's reply raised "CEC session is stopping",
    and the stored responder error turned a passing scenario into a cleanup
    failure. close() now sets the flag under the lock, waiting for any frame
    already being handled, and workers drop frames read after stop.
2026-11-12 Note why source isolation needs only delivered wire frames
    A directed wake to an unclaimed TV address is NACKed at its header, so
    its opcode never reaches the AVR-side wires and no equipment receives it.
    Wakes to present equipment are delivered to the observer.
2026-11-12 Keep inactive-equipment observations open through Standby
    qualified_names, removal_cascade and amity_replacement closed their
    no-control observation before the activity's Standby. The inactive
    equipment was already in standby, so a Standby misrouted to the
    same-named devices on another owner or adapter went unnoticed.
2026-11-12 Check discovery generation in single-owner scoped scan checks
    Powering a returning device re-announces its wire siblings, and queries
    that follow such an announcement count as targeted metadata. The scoped
    witness check ignored discovery state, so a scan triggered by a passive
    return could pass. With a single owner the UI generation and busy flag
    describe only that owner's completed scan, so the scoped check now also
    requires them unchanged; the multi-owner and lookup checks keep the
    physical evidence only.
2026-11-12 Check old Standby precedes new power-on in BLE handoffs
    assert_transition verified the old source's Standby and the new source's
    power-on separately but not their order. Within one owner, require the
    old-only Standby before the new-only power-on; different owners still
    run their sequences independently.
2026-11-12 Settle unadmitted and failed adapter settings writes
    A settings write rejected before admission (a 503 capacity reply) never
    enters the main's operation ledger, so every cleanup poll returned 404;
    a write the firmware confirmed failed was polled and re-raised forever.
    Neither changed the board. A 404 on the proven main boot now settles the
    write as not admitted, and a failed write clears its pending record after
    reporting the failure once.
2026-11-12 Stop the run after a scenario's fixture cleanup fails
    The runner stopped early only for required steps or deliberately
    retained DUT state, so a leaked setting or member from a failed cleanup
    carried into every remaining scenario on the same main. Treat test bed
    cleanup errors the same way.
2026-11-12 Time the FW RESET safety deadline from the low edge
    The Add-hold safety alarm was min(seconds + 2, 8) and started before the
    two pinctrl calls that drive the pin low, so an 8 s hold always tripped
    it just before completing. Arm the alarm after the pin is low, at
    min(seconds + 0.5, 8.5): an 8 s hold completes, and with the one-second
    bounded release the press still ends before the ten-second reset
    gesture.
2026-11-12 Pace BLE handoff readiness polling
    The readiness thread re-read /api/status with no pause while activity
    setup, the gate probes and the one-second fallback were being timed,
    loading the main's HTTPS server during the timing under test. Poll every
    50 ms.
2026-11-12 Fail the CEC session when the kernel drops received messages
    The responder descriptor never read core CEC events, so a receive-queue
    overflow's LOST_MSGS event went unnoticed and negative assertions and
    idle-coverage proofs could pass over frames that were never delivered.
    Drain pending events whenever the kernel signals them and treat a lost
    message as a responder failure.
2026-11-12 Replace a server-closed idle HTTPS connection before sending
    The firmware's web server purges idle sockets when its slots fill. A
    reused connection it had closed failed the next request, which the
    transport correctly never resends. Check an idle socket before reuse:
    readability means EOF, a TLS close alert or unexpected data, so drop it
    and send the request once on a fresh connection.
2026-11-12 Advertise the source RC profile for non-TV fixture devices
    CEC 2.0 Report Features carried RC profile 0x00 for every emulated
    device, which declares a TV profile. Sources and audio systems use the
    source profile (bit 6). Apply it to the Python replies and announcements
    and to the features the kernel broadcasts at address claim.
2026-11-12 Grant and check the CEC pin-monitor sudo helper in setup
    The CEC backend falls back to a sudo helper to open a pin monitor, but
    setup's sudoers grant omitted it; installations only worked because the
    account already had blanket passwordless sudo, and setup --check could
    not notice. Grant the exact runtime Python and helper invocation, and
    verify it with sudo -l during readiness.
2026-11-12 Pin the runtime's full dependency closure
    Only the five top-level runtime packages were pinned, so transitive
    dependencies such as zeroconf, bleak, cryptography and PyYAML drifted
    between Pis set up at different times and rerunning setup never aligned
    them. Add runtime-constraints.txt with every transitive version, resolved
    for Linux aarch64 and Python 3.13 from releases at least two weeks old;
    install with it and verify every pinned version.
2026-11-12 Flash every present DUT when another is missing
    flash-duts verified the whole USB inventory first, so one absent or
    inaccessible board stopped every board from being flashed, contrary to
    the README's per-board reporting. Locate each board independently,
    report a missing one as its own failure, and flash the rest.
2026-11-12 Keep runner unit tests away from the Pi's status LED
    Several runner and trace unit tests called main() without
    --no-status-led or a patch, so running the hardware-free suite on the Pi
    started the real LED helper, which writes /sys/class/leds through sudo.
    Stub the helper for those test classes.
2026-11-12 Submit only the UI's activity editor fields in set_configuration
    set_configuration forwarded the fetched editor document minus
    device_choices, so component_owners and any other read-only field went
    along and the firmware's field allowlist rejected the save. Build the
    same submission the UI does: version, request ID, expected revisions and
    activity rows limited to their accepted fields.
2026-11-12 Accept only confirmed UI operation stages and bound each poll
    wait_operation treated any stage outside its pending and failure sets as
    success, including a missing, empty or new stage; the UI accepts only
    complete or applied. Each poll also used the fixed 15 s request timeout,
    overrunning the operation deadline. Require a confirmed stage and limit
    every poll to the remaining time.
2026-11-12 Let an earlier member's checks accept later proven members
    _preserved_members compared the live roster with this member's initial
    snapshot, which predates any member added after it in the same bed, so
    assert_connected, adapter settings and their restore on the earlier
    member failed while a later sibling was enrolled. Accept members proven
    later in the bed, fenced by their own proven name and boot. A removal
    review still requires its survivors to be named explicitly.
2026-11-12 Describe the current two-owner switch-input activity test
    The README's detailed text described an older single-owner test that
    verifies input 4. The test now edits an inactive main row from input 4
    to 3 during member playback and verifies input 3.
2026-11-12 Describe the silent-status activity case in the README
    test_activity_without_status_replies was not described anywhere.
2026-11-12 Drop references to the removed remote CEC RPC backend
    The README, the pin monitor and CecSession.close still described remote
    workers and a 20-second RPC, removed when functional tests moved
    entirely onto the Pi. close() waited 30 s for workers on that basis;
    frame handling now finishes under the session lock before stop, so a
    worker only completes its 50 ms receive poll, and 5 s bounds a wedged
    kernel call.
2026-11-12 Describe the wire-wide address reclaim on Off power changes
    The README said Off removes "the logical address". Linux claims an
    adapter's addresses only as one set, so any change between Off and a
    powered state clears and reclaims every address on that wire, during
    which siblings NACK and nothing is received.
2026-11-12 Report member Wi-Fi signal to the main's diagnostics
    Each Amity samples its station signal every ten seconds and logs a warning
    only while it is below -70 dBm. Members report changes to the main at most
    every ten seconds; the main exposes them in /api/system and the UI lists
    them under Advanced > Diagnostics.
2026-11-13 Edit suggested activities in the activity editor
    Editing a scanned suggestion opened a separate dialog that had drifted
    from the activity editor: a different title, an unhighlighted OK placed
    before Cancel, no Save and start, and errors shown behind the dialog.
    Suggestions now open in the activity editor itself. OK still updates the
    suggestion for the row's Add button; Save and start adds, saves and
    starts it like a new activity.
2026-11-13 Make dialog buttons and destructive actions consistent
    Device settings puts Refresh on the left and a borderless Cancel beside
    a highlighted Save on the right, adds an "Adapter physical addresses"
    heading, and moves the blank-address hint below the table. Add Amity
    ends with a borderless Cancel and a highlighted Add; Remove Amity puts a
    filled red Remove Amity beside a highlighted Cancel.
    Every outlined destructive button now uses the same filled danger red:
    Remove on device rows, Matter and HomeKit removal, Factory reset and
    Unpair remote. Device rows order their actions Remove, Replace,
    Settings, and "Not responding" is shown in red.
2026-11-13 Let the remote tab stop pairing
    While Amity searches for or connects to a remote, the button now reads
    Stop pairing and stops it, as in the Matter and HomeKit tabs. POST
    /api/remotes/stop calls ble_remote_stop_pairing(), which ends the search
    or drops the unbonded setup link and releases the radio without pausing
    background work. A saved bond is never touched.
    A stopped setup ends the way Matter's cancellation does. Otherwise radio
    control clears setup_cancelled within 100 ms, and the abandoned link
    reaches the failure path: it reports "Pairing failed" and removes the
    half-made bond while the controller is still cancelling the connection,
    which can set bond_cleanup_failed and block later pa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
2026-11-13 Put device status under the name and stack actions on phones
    Each Amity device row shows its status directly below the name. The main
    Amity's title is its hostname alone, and its status reads "This device"
    instead of the old "(this device)" suffix. The name's first line stays
    level with the top button.
    Below 650 px the row's actions stack at one shared width, Settings on
    top and Remove at the bottom, so long names no longer break mid-word.
    Wider screens keep the single row Remove, Replace, Settings.
    The layout test measures the live card in one snapshot. Before, a card
    replaced by the polling refresh read as all-zero rectangles, which
    passed the alignment checks without measuring anything.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
2026-11-13 Make indigo the UI color
    The admin UI's green becomes indigo. Buttons, links and highlights use
    #4a43c4 (7.3:1 against white), with #3b35a3 on hover. The selected tab's
    underline is a brighter #6d66e6. Backgrounds, borders, tints and text
    take the same hue at their previous lightness. Danger red and warning
    amber are unchanged, and every text color keeps at least 4.5:1 contrast
    against its background.
    The color properties --green and --sage become --primary and --tint.
2026-11-14 Require a Wi-Fi passphrase for bench enrollment
    A 64-digit raw WPA key joins WPA2 networks only. On a WPA2/WPA3 network
    the board authenticates with SAE, which needs the passphrase, so Matter
    Wi-Fi commissioning failed with an authentication error. Enrollment
    credentials now accept only an 8-63 character printable ASCII
    passphrase, and harness setup and --check reject a missing or invalid
    enrollment file.
2026-11-14 Default the CEC timeout to half a second
    Fresh CEC key, power and routing assertions now wait 0.5 s by default
    instead of 1 s. --cec-timeout still overrides it.
